VaraiTamas/yoRadio/yoRadio/locale/glcdfont/GR/readme.txt

Η βιβλιοθήκη Adafruit_GFX δεν υποστηρίζει Unicode. 
Επομένως, για να εμφανίσουμε ελληνικούς χαρακτήρες Unicode, πρέπει:
1) Να αλλάξουμε τη γραμματοσειρά Arduino/libraries/Adafruit_GFX_Library/glcdfont.c
2) Να γράψουμε μια συνάρτηση μετατροπής unicode σε ascii για τα ελληνικά.
   Ένα παράδειγμα μιας τέτοιας συνάρτησης για τη ρωσική γλώσσα υπάρχει στο αρχείο 
   yoRadio/src/displays/tools/utf8Rus.cpp, οπότε σε αυτό κάνουμε τις απαραίτητες 
   προσθήκες για την εμφάνιση των ελληνικών χαρακτήρων.

Τα αρχεία από αυτό το ZIP έχουν τις απαραίτητες αλλαγές για υποστήριξη ελληνικών 
και πρέπει να αντιγραφούν στις ακόλουθες τοποθεσίες:
ο) glcdfont.c           ----> \Arduino\libraries\Adafruit_GFX_Library
