VaraiTamas/yoRadio/Aliexpress/Aliexpress_links.txt

********************************************************************************************************************
******************************************       Hozzávalók / accessories:      ************************************
********************************************************************************************************************

- ESP32 S3 Development Board 2.4G Wifi Bluetooth Module Dual-Core Processor ESP32-S3 N16R8 44Pin Type-C ESP32-S3
https://www.aliexpress.com/item/1005009170360406.html

- Interface I2S PCM5102A DAC Decoder GY-PCM5102 I2S Player Module For Raspberry Pi pHAT Format Board Digital PCM5102 Audio Board
https://www.aliexpress.com/item/1005006104038963.html

- IPS 4.0 Inch Red Module ILI9488 Factory TFT LCD 480*320 DIY Display 14 Pin Electronic Board
https://www.aliexpress.com/item/1005006287831546.html

- 1-10Pcs With Switch Rotary Encoder Module for Arduino Brick Sensor Development Round Audio Rotating Potentiometer Knob Cap EC11
https://www.aliexpress.com/item/1005001696915804.html?spm=a2g0o.order_list.order_list_main.116.1e251802zpJnqp

- 5 Volt 1-10Pcs AC-DC 3.3V/5V/12V Precision Buck Converter AC220v toDC 3.3V/5V/12V DC step down Transformer power supply module 1A 12W
https://www.aliexpress.com/item/10000159007917.html

- 4PCS RCA Female Socket Lotus Connector Chassis Panel Mount Adapter Audio Terminal Plug 3.5mm AV Plug Gold Plated
https://www.aliexpress.com/item/1005008621695365.html

- 1~10pcs 2 Pin 4 Pin USB 2.0 Female Power Jack 2P 4P USB 2.0 Charging Port Connector Data Interface with Cable USB Charger Socket
https://www.aliexpress.com/item/1005005673022752.html

- PJ-392A 3/4 Pin 3.5mm Audio Jack Socket 3/4 Pole Stereo Solder Panel Mount 3.5 mm Headphone Female Socket Connector With Nut
https://www.aliexpress.com/item/1005003621329893.html

- Universal Learn Remote Control Work for 2 devices Copy IR Code for TV VCR STB DVD DVB BOX 2 in 1 Controller Easy for Old People.
https://www.aliexpress.com/item/32960027990.html

- VS1838B IR sensor
https://www.aliexpress.com/item/1005005407437987.html

- 48 x 15 mm-es 4Pcs Speaker Spikes Stand Feets Audio Active Speakers Repair Parts Accessories DIY For Home Theater Sound System
https://www.aliexpress.com/item/1005006345065523.html

- Grwibeou 2 IN 1 USB Bluetooth 5.0 Adapter Transmiter 3.5mm AUX Jack
https://www.aliexpress.com/item/1005006421639768.html

- 16mm Metal Illuminated Black Push Button Switch Led Light 5v Momentary Latching Waterproof Power Flat Head
https://www.aliexpress.com/item/1005009195056493.html

- 10PCS Single Row Pin Female Header Socket Pitch 2.54mm 22p Pin Connector
https://www.aliexpress.com/item/1005007563546219.html

- 25 x 13mm Black aluminum knob encoder sound card potentiometer inner hole 6mm knob volume power amplifier adjustment metal cap
https://www.aliexpress.com/item/1005008473117765.html

- 2.4GHz 3dBi WiFi 2.4g Antenna Aerial RP-SMA Male wireless router+ 17cm PCI U.FL IPX to RP SMA Male Pigtail Cable ESP8266 ESP32
https://www.aliexpress.com/item/1005006781542881.html

- CPQ For TAA 125V/15A 250V/10A 12mm Thread Screw Cap Panel Mounted Fuse Holders 5 Pieces 2025
https://www.aliexpress.com/item/1005009550935137.html

3.3V 1 Channel Relay Module High And Low Level Trigger Dual Optocoupler Isolation Relay Module Board
https://www.aliexpress.com/item/1005005514531757.html

4PCS Audio Isolation Feet 40*10mm Plastic Amplifier Feet Speaker Pad CD DAC Speakers Shock Absorption Feet Pad
https://www.aliexpress.com/item/1005007017368257.html
