VaraiTamas/yoRadio/docs/presets.md

## 📻 YoRadio – Presets kezelési útmutató
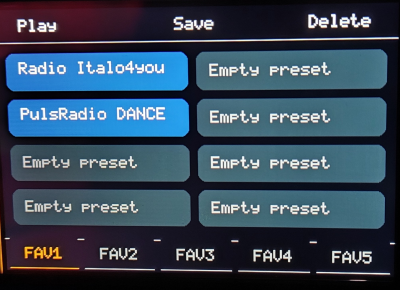
[picture p17: images/presets.png]
Projekt logó


A Presets rendszer lehetővé teszi, hogy bármely rádióállomást elments és később egyetlen érintéssel visszahívd, még akkor is, ha a playlist időközben megváltozik. Érintéses képernyőmód bekapcsolása szükséges és csak 320x480 pixeles felbontáson működik. Mentés az NVS memóriába történik.

## ▶️ Egy preset használata

- Lejátszás módban a felső címsáv rövid érintésével lépj a Presets képernyőre.

- Egy képernyőn 8 darab kártya található melyek alá egy - egy rádióállomás menthető. 5 darab képernyő tehát összesen 40 darab csatornát lehet elmenteni. 
- A fejlécen lévő Lejátszás Mentés Törlés feliratok alatt a kártya érintésével egy idővonal indul el mely mutatja, ha elengedjük a kártyát melyik funkció fog végrehajtódni. 
    - Lejátszásnál a mentett csatorna indul.
    - Mentésnél az éppen hallgatott csatorna kerül mentésre ha volt eddig mentve a kártyára, azt felülírja.
    - Törlésnél a kártyára memóriája kerül kiürítésre.
- Alul található FAV1 - FAV5 gombokkal lehet váltani a lapokat. Hosszan nyomva a FAV gombon megjelenik egy billentyűzet és ott szerkeszthető a FAV gomb felirata 12 karakterig. Ha túl hosszú a szöveg a betűméret kicsinyítésre kerül. 

A lejátszási listának nincs hatása a mentett presetekre. Ha közben a lejátszási lista cserélve van a presets kártyákra mentett csatornák nem változnak.

👻 Szellem presetek javítása

Ha korábban elfogyott az NVS memória, előfordulhat:

Van ID, de nincs név vagy URL program automatikusan:

- Törli az ilyen hibás bejegyzéseket

- Nem engedi, hogy „láthatatlan” preset maradjon

---

### Ha támogatni szeretnéd a munkámat itt meghívhatsz egy kávéra!!!     
<a href="https://buymeacoffee.com/vtom">
    
</a>
