VaraiTamas/yoRadio/images/MB_2.0/MB_search.md

# Új WEB kereső hozzáadva v2.0 (by Mirosław Bubka)<br><br>
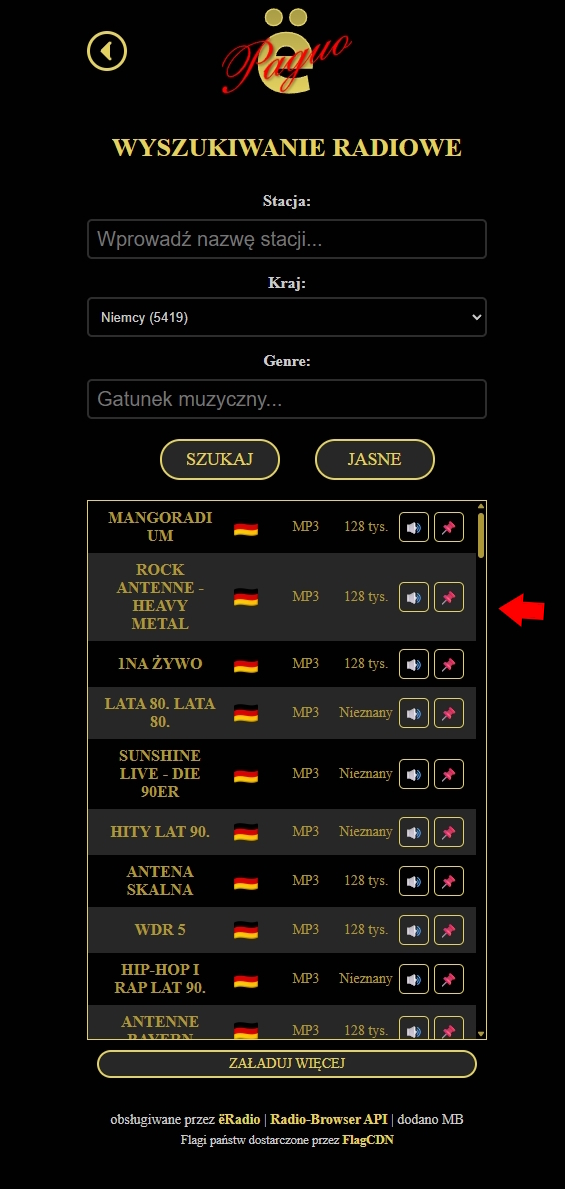
[picture p18: images/MB_2.0/1.jpg]
<br><br>
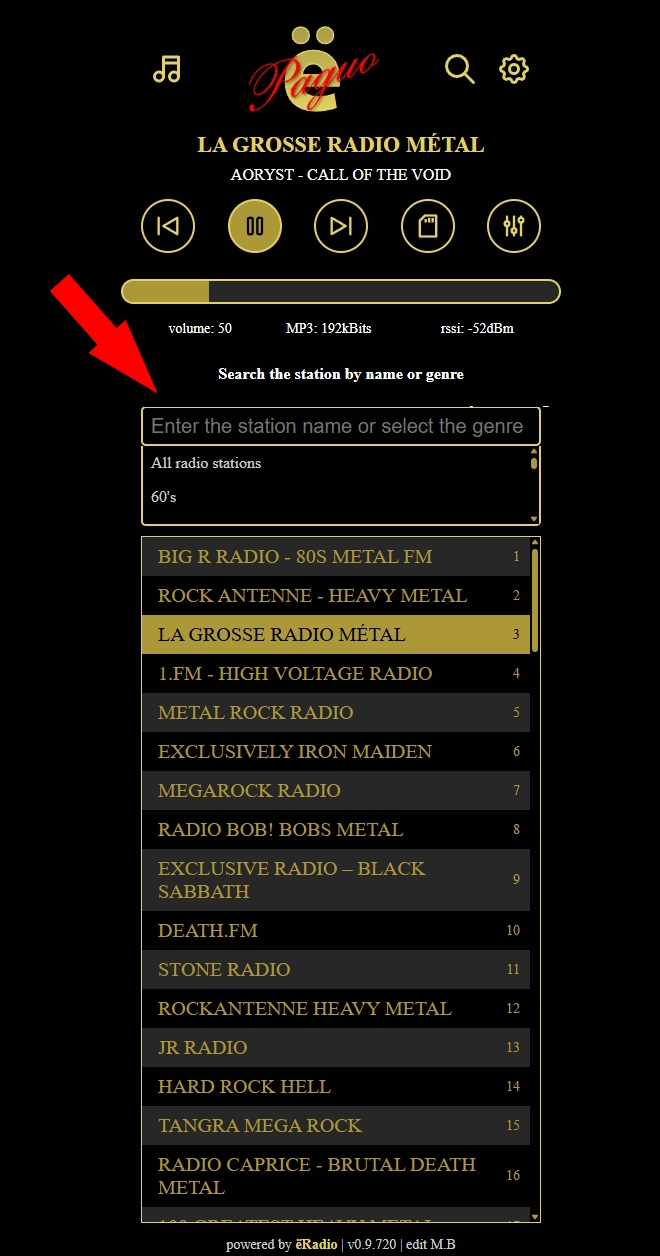
[picture p19: images/MB_2.0/2.jpg]
<br><br>
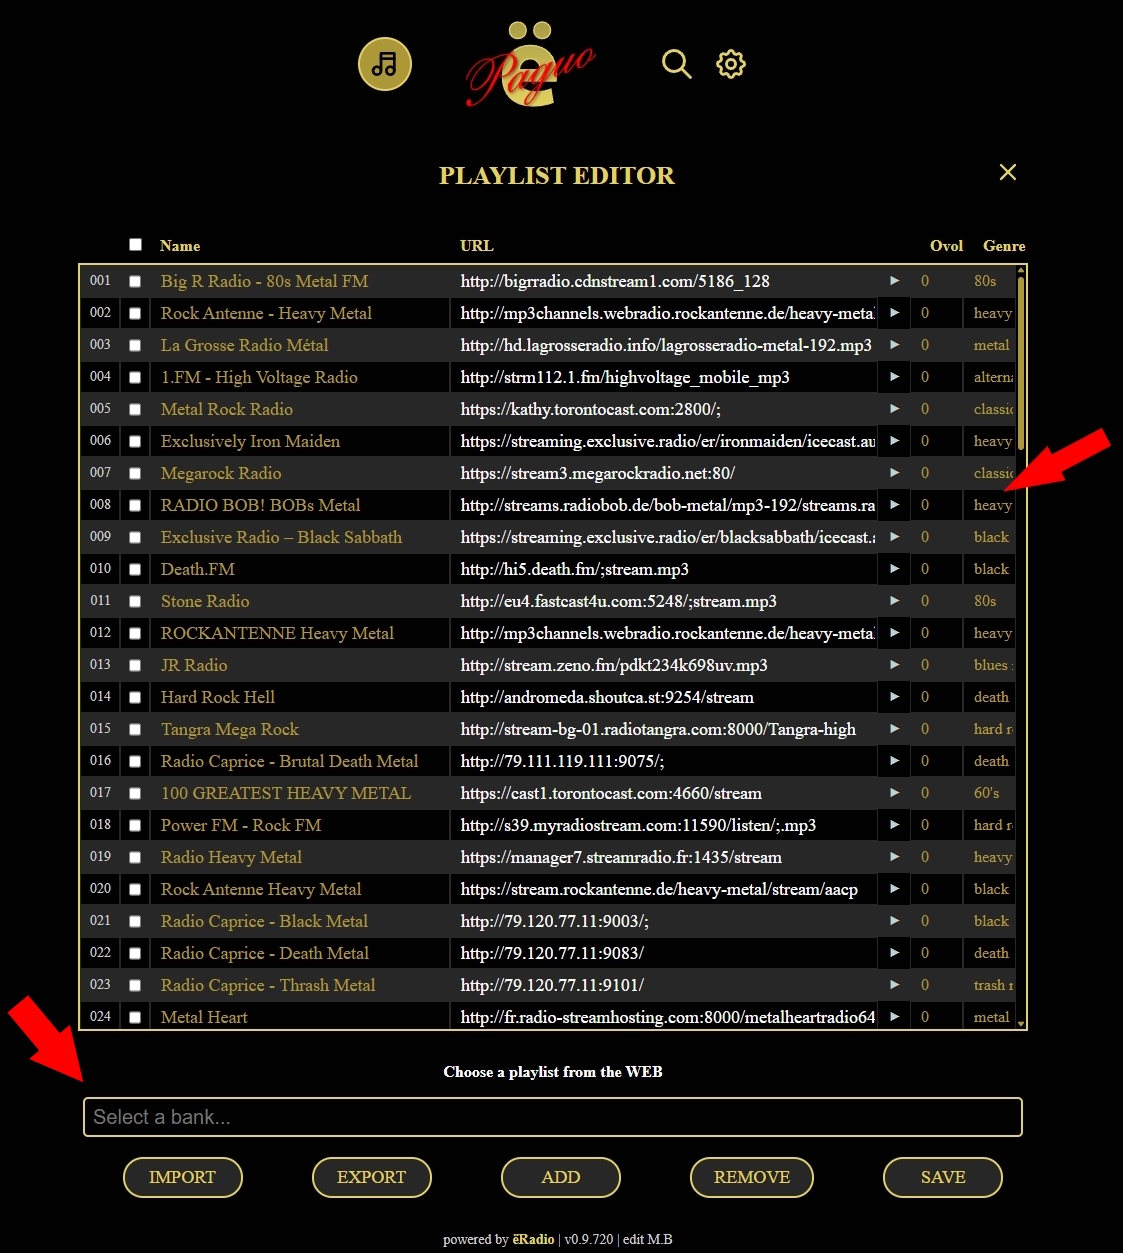
[picture p20: images/MB_2.0/3.jpg]
<br><br>
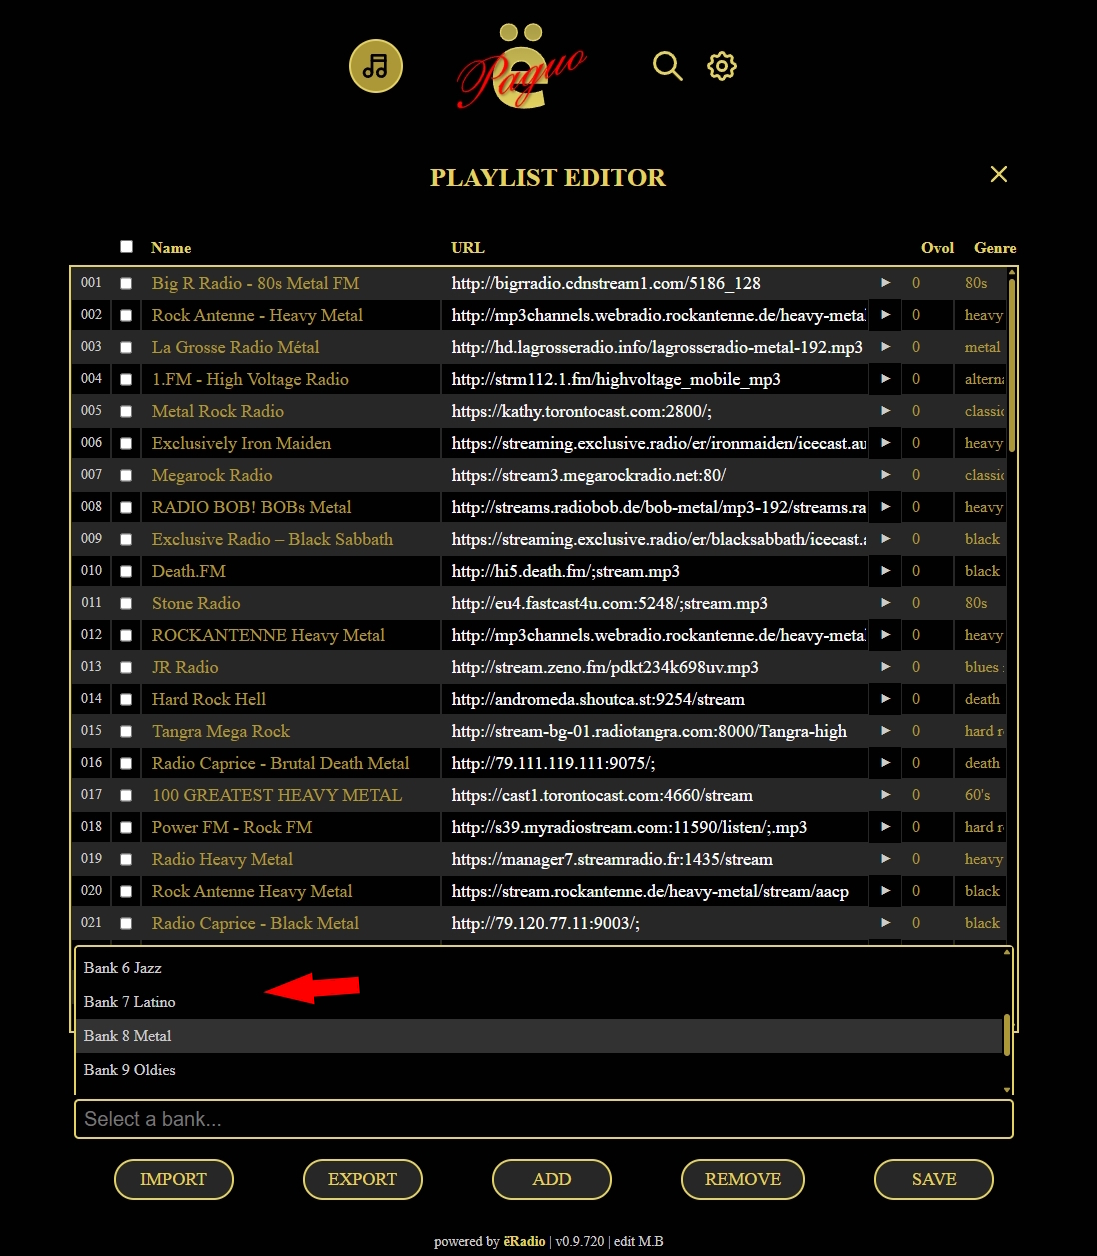
[picture p21: images/MB_2.0/4.jpg]
<br><br>
