VaraiTamas/yoRadio/images/box_back.png

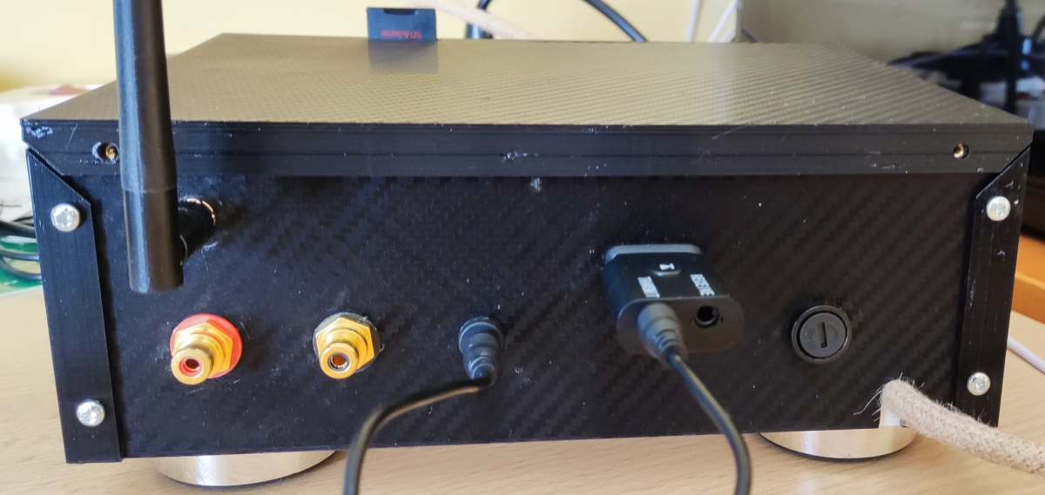
images/box_back.png
