VaraiTamas/yoRadio/images/box_front_top.png

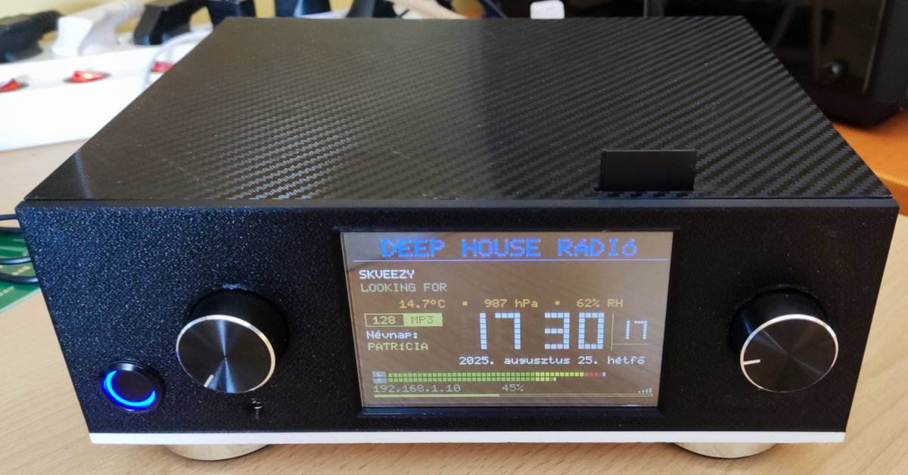
images/box_front_top.png
