VaraiTamas/yoRadio/images/box_inside_1.png

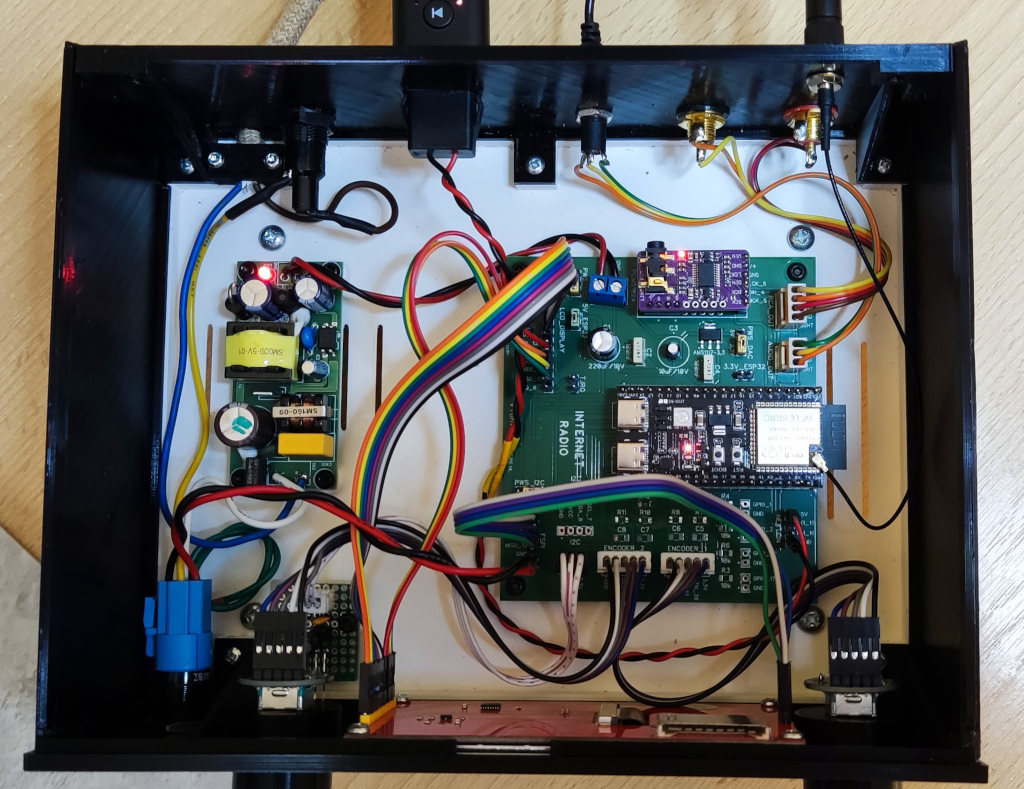
images/box_inside_1.png
