VaraiTamas/yoRadio/images/box_right.png

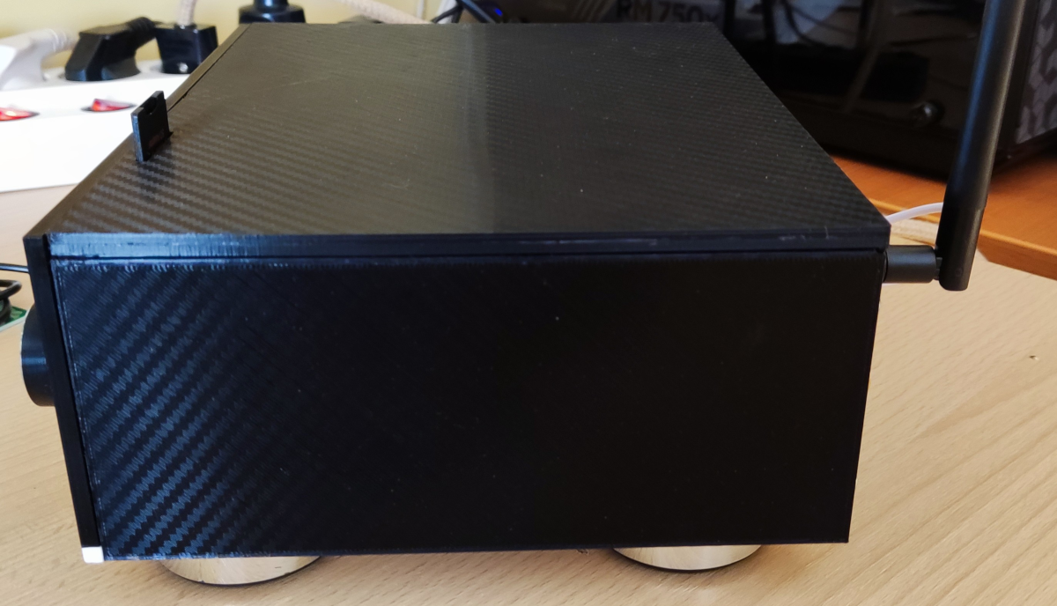
images/box_right.png
