VaraiTamas/yoRadio/PCM5102A/PCM5102A DAC I2S pinouts.jpg

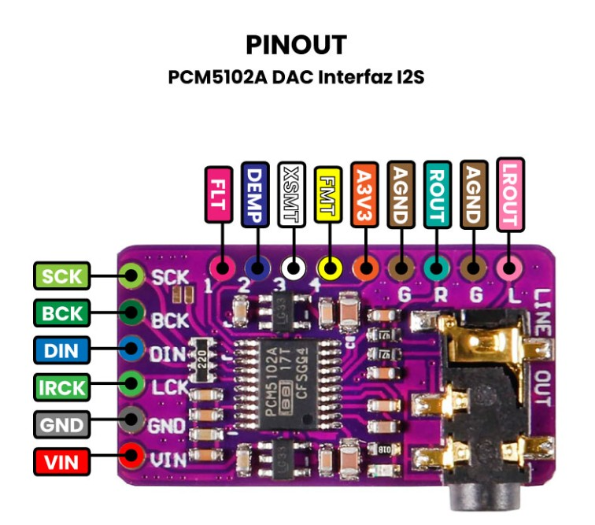
PCM5102A/PCM5102A DAC I2S pinouts.jpg
