VaraiTamas/yoRadio/Arduino IDE settings/Arduino IDE setup.png

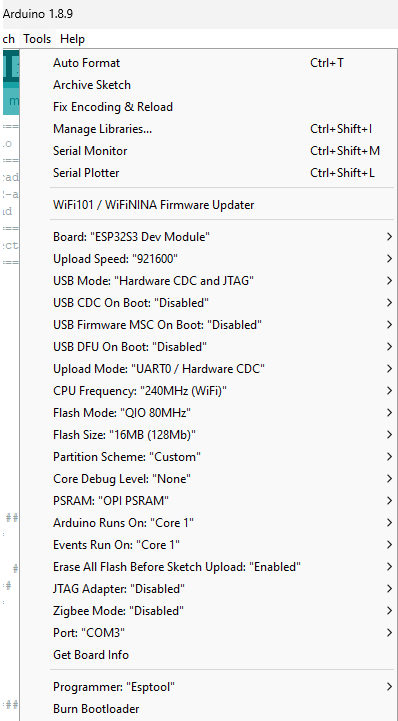
Arduino IDE settings/Arduino IDE setup.png
