VaraiTamas/yoRadio/Arduino IDE settings/Boards Manager_ESP32_v3.3.6 setup.png

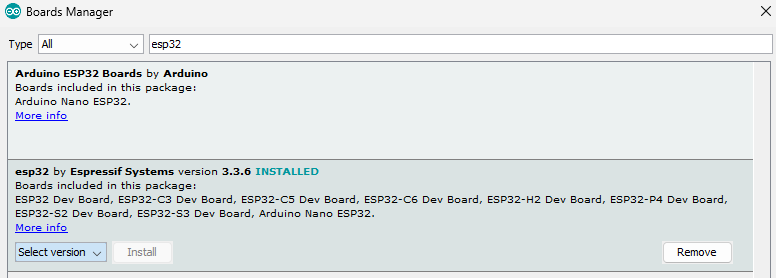
Arduino IDE settings/Boards Manager_ESP32_v3.3.6 setup.png
