VaraiTamas/yoRadio/PCB/PCB_2025_06_14/wiring diagram 2025.06.14.pdf

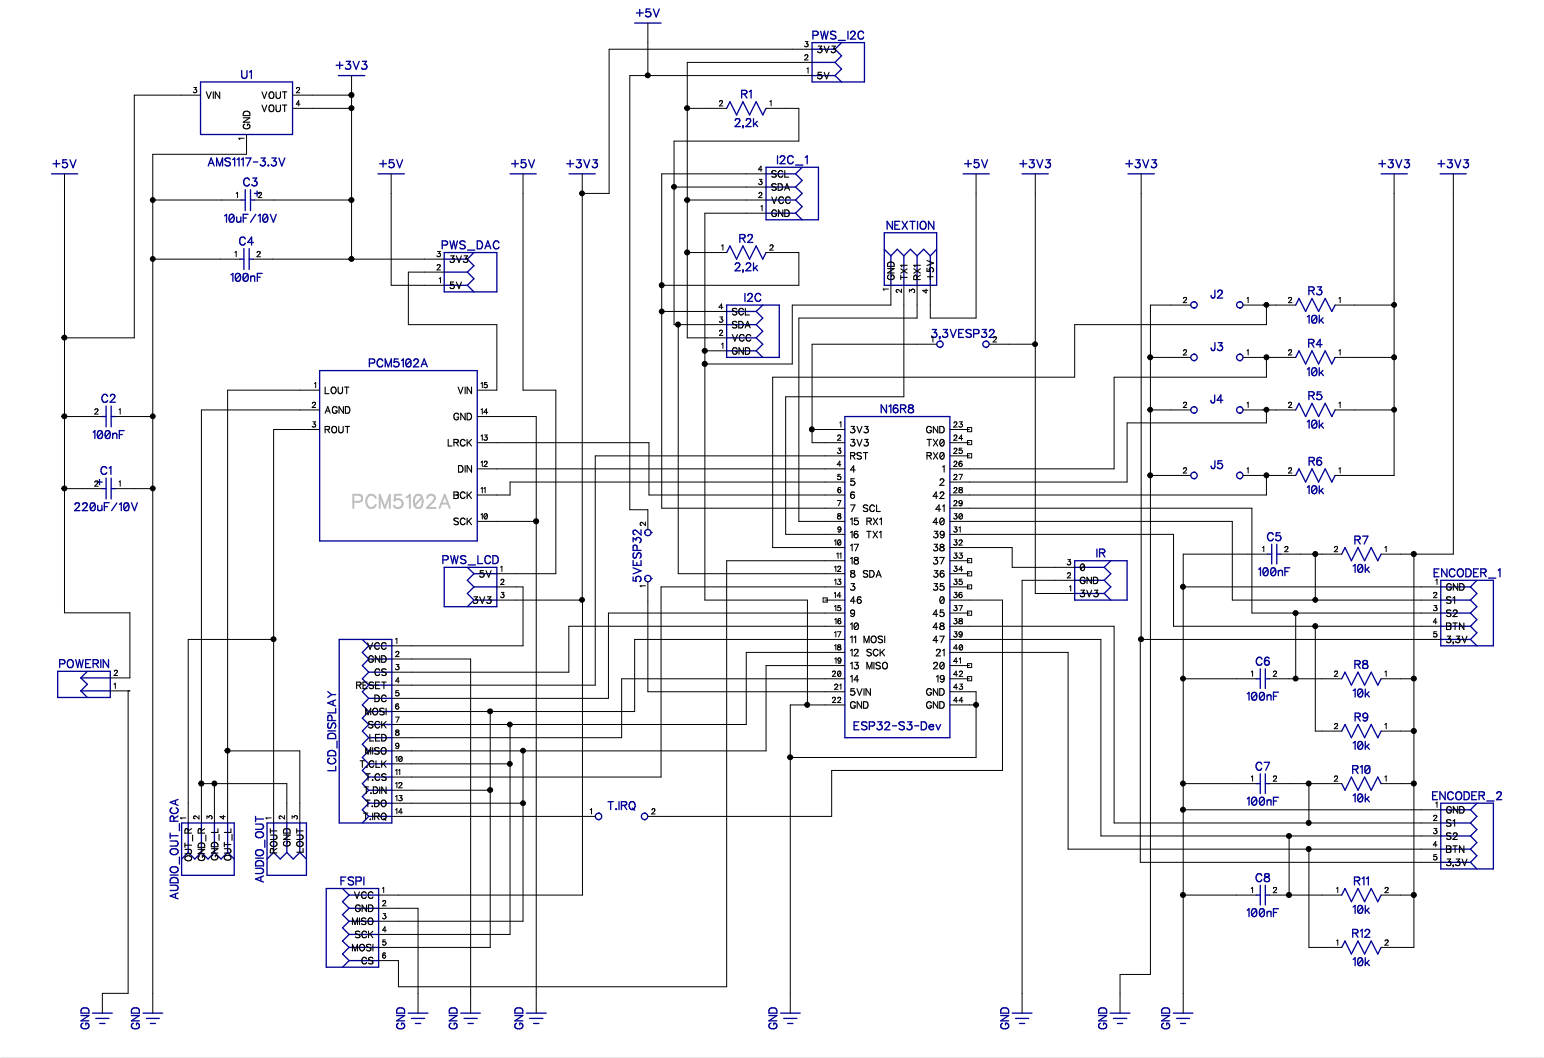
[picture p30: page 1]

3 | SCL
2 | SDA

4 | 26 27

1 | GND 3 V 3

13 MISO 19 14 20 5VIN 21

GND 22

3 | S 1
4 | S 2
5 | BTN
3,3 V
