VaraiTamas/yoRadio/PCB/PCB_2025_12_21/wiring_diagram__2025_dec_21.pdf

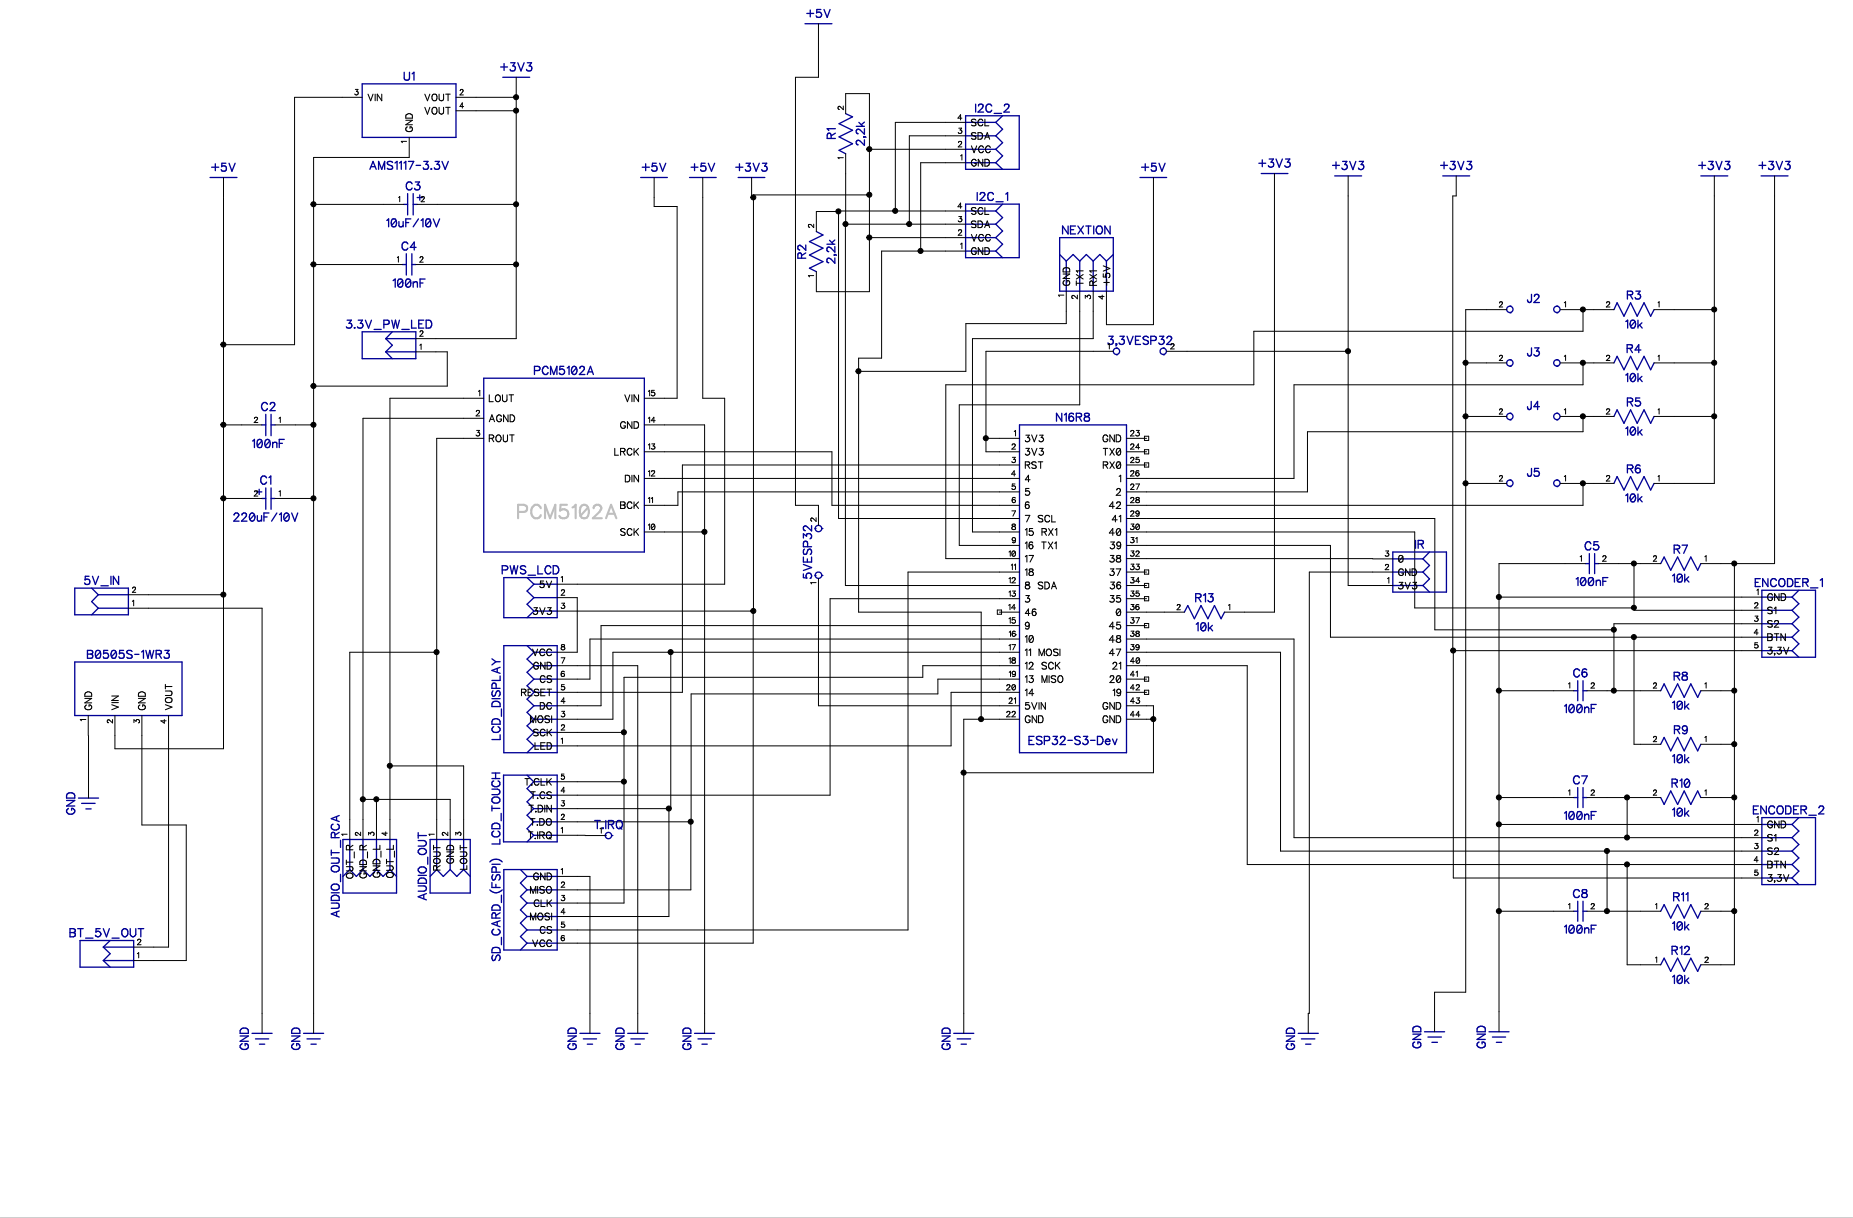
[picture p31: page 1]

10 16
11 MOSI 17
12 SCK 18
13 MISO 19 14 20 5VIN 21

GND 22
