VaraiTamas/yoRadio/PCB/Power_supply_with_IR_sensor/wiring_diagram_2026_jan_03.pdf

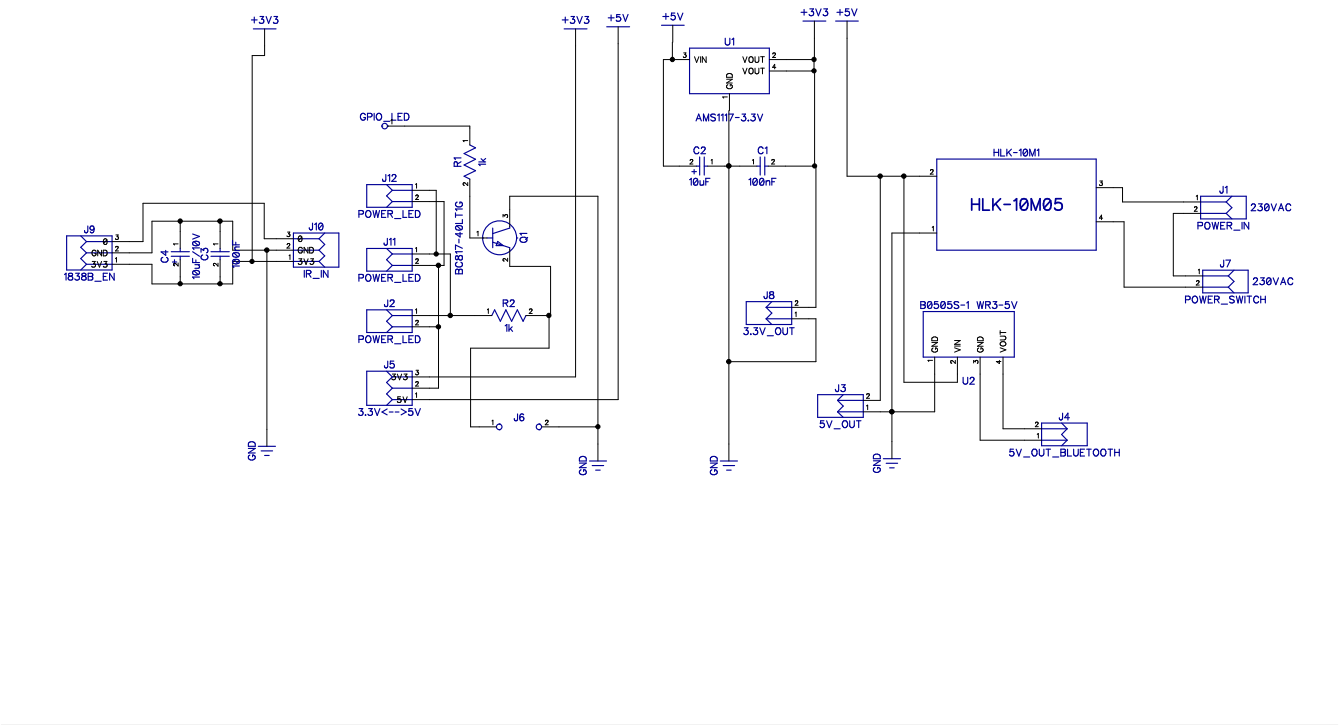
[picture p32: page 1]
