VaraiTamas/yoRadio/(list of files, drawings)

Other design files:
PCB/PCB_2025_12_21/Diptrace/PCB_2025_dec_21.dip
PCB/PCB_2025_12_21/Diptrace/schematics_2025_dec_21.dch
PCB/Power_supply_with_IR_sensor/Diptrace/power_supply_width_ir.dip
PCB/Power_supply_with_IR_sensor/Diptrace/power_supply_with_ir.dch
