VaraiTamas/yoRadio/yoRadio/src/audioI2S/Audio.cpp

/*****************************************************************************************************************************************************
    audio.cpp

    Created on: 28.10.2018                                                                                                  */
char audioI2SVers[] = "\
    Version 3.4.5h                                                                                                                            ";
/*  Updated on: Mar 18, 2026

    Author: Wolle (schreibfaul1)
    Audio library for ESP32, ESP32-S3 or ESP32-P4
    Arduino Vers. V3 is mandatory
    PSRAM is mandatory
    external DAC is mandatory

*****************************************************************************************************************************************************/

#include "Audio.h"
#include "aac_decoder/aac_decoder.h"
#include "flac_decoder/flac_decoder.h"
#include "mp3_decoder/mp3_decoder.h"
#include "opus_decoder/opus_decoder.h"
#include "psram_unique_ptr.hpp"
#include "vorbis_decoder/vorbis_decoder.h"
#include "wav_decoder/wav_decoder.h"

// constants
constexpr size_t m_frameSizeWav = 4096;
constexpr size_t m_frameSizeMP3 = 1600 * 2;
constexpr size_t m_frameSizeAAC = 1600 * 2;
constexpr size_t m_frameSizeFLAC = UINT16_MAX;   // max ogg size
constexpr size_t m_frameSizeOPUS = UINT16_MAX;   // max ogg size
constexpr size_t m_frameSizeVORBIS = UINT16_MAX; // OGG length is normally 4080 bytes, but can be reach 64KB in the metadata block
constexpr size_t m_outbuffSize = 4608 * 2;
constexpr size_t m_samplesBuff48KSize = m_outbuffSize * 8; // SRmin: 6KHz -> SRmax: 48K

constexpr size_t AUDIO_STACK_SIZE = 3500;

// static allocations for Audio task
StaticTask_t __attribute__((unused)) xAudioTaskBuffer;
StackType_t __attribute__((unused))  xAudioStack[AUDIO_STACK_SIZE];

// weak default implementation - can be overridden by user
__attribute__((weak)) void audio_process_i2s(int32_t* outBuff, int16_t validSamples, bool* continueI2S) {
    // Default: do nothing. User can provide their own implementation to process audio data.
}
__attribute__((weak)) void audio_process_raw_samples(int32_t* outBuff, int16_t validSamples) {
    // Default: do nothing. User can provide their own implementation to process audio data.
}

// —————————————————————————————————————————————————————————————————————————————————————————————————————————————————————————————————————————————————————————————————————————————————————————————————————
// 📌📌📌  A U D I O B U F F E R  📌📌📌
// —————————————————————————————————————————————————————————————————————————————————————————————————————————————————————————————————————————————————————————————————————————————————————————————————————

// AudioBuffer will be allocated in PSRAM
//
//  m_startPtr       m_readPtr                  m_writePtr                                                    m_endPtr
//   |                  |<------maxAvailableBytes----->|<--------------------- writeSpace ----------------------->|
//   ▼                  ▼                              ▼                                                          ▼
//   ---------------------------------------------------------------------------------------------------------------
//   |                         <--m_mainBuffSize-->                               |      <--m_resBuffSize -->     |
//   ---------------------------------------------------------------------------------------------------------------
//   |<---freeSpace---->|<------------filled---------->|<-------freeSpace-------->|
//                                                                                ▲
//                                                                                |
//                                                                             m_buffEnd
//   if resBuff is full copy data from resBuff to the beginning
//   if m_readPtr >= m_buff<end set m_readptr to m_startPtr + (m_readPtr - m_buffEnd)
//
//  m_startPtr                      m_writePtr                 m_readPtr                                      m_endPtr
//   |                                 |<-------writeSpace------>|<---------------maxAvailableBytes-------------->|
//   ▼                                 ▼                         ▼                ▼                               ▼
//   ---------------------------------------------------------------------------------------------------------------
//   |                        <--m_mainBuffSize-->                                |      <--m_resBuffSize -->     |
//   ---------------------------------------------------------------------------------------------------------------
//   |<------------filled------------->|<-------freeSpace------->|<----filled---->▲
//                                                                                |
//                                                                             m_buffEnd
//

AudioBuffer::AudioBuffer() {
    m_mainBuffSize = UINT16_MAX * 10;
    m_resBuffSize = UINT16_MAX;
}

AudioBuffer::~AudioBuffer() {
    ;
}

size_t AudioBuffer::getBufsize() {
    return m_mainBuffSize;
}

size_t AudioBuffer::init() {
    m_buffer.alloc(m_mainBuffSize + m_resBuffSize, "AudioBuffer");
    m_mutex = xSemaphoreCreateBinary();
    xSemaphoreGive(m_mutex);
    m_init = true;
    m_startPtr = m_buffer.get();
    m_endPtr = m_buffer.get() + m_mainBuffSize;
    m_buffEnd = m_endPtr + m_resBuffSize;
    reset();
    return m_mainBuffSize;
}

void AudioBuffer::setMaxBlocksize(uint32_t mbs) {
    m_maxBlockSize = mbs;
}

size_t AudioBuffer::getMaxBlockSize() {
    return m_maxBlockSize;
}
//----------------------------------------------------------------------------------------------------------------------------------------------------
size_t AudioBuffer::freeSpace() {
    if (!m_init) return 0;
    if (m_readPtr == m_writePtr) {
        if (m_isEmpty) { return m_mainBuffSize; }
        if (m_isFull) { return 0; }
        log_e("writePtr == readPtr, writePtr %i, readPtr %i", m_writePtr - m_startPtr, m_readPtr - m_startPtr);
    }
    if (m_readPtr < m_writePtr) {
        if (m_writePtr > m_endPtr) {
            return (m_readPtr - m_startPtr);
        } else {
            return (m_endPtr - m_writePtr) + (m_readPtr - m_startPtr);
        }
    }
    return m_readPtr - m_writePtr;
}
//----------------------------------------------------------------------------------------------------------------------------------------------------
size_t AudioBuffer::bufferFilled() {
    if (!m_init) return 0;
    xSemaphoreTake(m_mutex, portMAX_DELAY);
    size_t bufferFilled = 0;
    if (m_readPtr == m_writePtr) {
        if (m_isEmpty) {
            bufferFilled = 0;
            goto end;
        }
        if (m_isFull) {
            bufferFilled = m_mainBuffSize;
            goto end;
        }
        log_e("%s %i writePtr == readPtr, writePtr %i, readPtr %i", __FILE__, __LINE__, m_writePtr - m_startPtr, m_readPtr - m_startPtr);
    }
    if (m_readPtr < m_writePtr) {
        bufferFilled = (size_t)(m_writePtr - m_readPtr);
        goto end;
    }
    bufferFilled = (m_endPtr - m_readPtr) + (m_writePtr - m_startPtr);
end:
    xSemaphoreGive(m_mutex);
    return bufferFilled;
}
//----------------------------------------------------------------------------------------------------------------------------------------------------
size_t AudioBuffer::writeSpace() {
    if (!m_init) return 0;
    xSemaphoreTake(m_mutex, portMAX_DELAY);
    m_writeSpace = 0;

    // Check whether a complete block still fits in at the end
    size_t spaceToEnd = m_buffEnd - m_writePtr;

    if (m_isFull) {
        m_writeSpace = 0;
        goto end;
    }

    if (m_isEmpty) {
        m_writeSpace = min(m_maxRet, spaceToEnd);
        goto end;
    }

    if (spaceToEnd == 0) { // be sure that the resBuff is full
        // Only copy if the read pointer is not in the way
        if (m_readPtr > m_startPtr + m_resBuffSize) {
            memcpy(m_startPtr, m_endPtr, m_resBuffSize);
            // log_w("wrap copy %u bytes", m_resBuffSize);
            m_writePtr = m_startPtr + m_resBuffSize;
        }
    }

    if (m_writePtr < m_readPtr) {
        if (m_readPtr >= m_endPtr) {                                       // readPtr is in resBuff?
            m_writeSpace = min(m_maxRet, (size_t)(m_endPtr - m_writePtr)); // writePtr does not enter resbuff, wait for copy im readspace
        } else {
            m_writeSpace = min(m_maxRet, (size_t)(m_readPtr - m_writePtr));
        }
        goto end;
    }
    if (m_writePtr > m_readPtr) {
        m_writeSpace = min(m_maxRet, spaceToEnd);
        goto end;
    }

    log_e("%s %i writePtr == readPtr, writePtr %i, readPtr %i", __FILE__, __LINE__, m_writePtr - m_startPtr, m_readPtr - m_startPtr);

end:
    xSemaphoreGive(m_mutex);
    return m_writeSpace;
}
//----------------------------------------------------------------------------------------------------------------------------------------------------
void AudioBuffer::bytesWritten(size_t bw) {
    if (!m_init) return;
    xSemaphoreTake(m_mutex, portMAX_DELAY);
    if (!bw) goto end;

    if (bw > m_writeSpace) log_e("writeSpace < bw, writeSpace %i, bw %i", m_writeSpace, bw); // bw must not be larger than the queried m_writeSpace

    if (m_writePtr < m_readPtr && m_writePtr + bw > m_readPtr) {
        log_e("writePtr overrruns readPtr, writePtr %i, readPtr %i, bw %i", m_writePtr - m_startPtr, m_readPtr - m_startPtr, bw);
        m_writePtr = m_readPtr;
        goto end;
    }
    if (m_writePtr + bw > m_buffEnd) {
        log_e("writePtr overrruns buffEnd, writePtr %i, buffEnd %i, bw %i", m_writePtr - m_startPtr, m_buffEnd - m_startPtr, bw);
        m_writePtr = m_buffEnd;
        goto end;
    }

    m_writePtr += bw;
    if (bw) {
        if (m_writePtr == m_readPtr) m_isFull = true;
        m_isEmpty = false;
    }

end:
    xSemaphoreGive(m_mutex);
    return;
}
//----------------------------------------------------------------------------------------------------------------------------------------------------
size_t AudioBuffer::readSpace() {
    if (!m_init) return 0;
    xSemaphoreTake(m_mutex, portMAX_DELAY);

    if (m_readPtr >= m_endPtr && m_writePtr <= m_endPtr) {
        size_t len = m_readPtr - m_endPtr;
        if (m_writePtr > m_startPtr + len) {
            log_d("set new readptr to %i", len);
            m_readPtr = m_startPtr + len;
        }
    }

    m_readSpace = 0;
    if (m_isEmpty) { goto end; }

    if (m_isFull) {
        m_readSpace = min(m_maxRet, (size_t)(m_buffEnd - m_readPtr));
        goto end;
    }

    if (m_readPtr < m_writePtr) {
        m_readSpace = min(m_maxRet, (size_t)(m_writePtr - m_readPtr));
        goto end;
    }

    if (m_readPtr > m_writePtr) {
        m_readSpace = min(m_maxRet, (size_t)(m_buffEnd - m_readPtr));
        goto end;
    }

    log_e("%s %i writePtr == readPtr, writePtr %i, readPtr %i", __FILE__, __LINE__, m_writePtr - m_startPtr, m_readPtr - m_startPtr);
end:
    xSemaphoreGive(m_mutex);
    return m_readSpace;
}
//----------------------------------------------------------------------------------------------------------------------------------------------------
void AudioBuffer::bytesWasRead(size_t br) {
    if (!m_init) return;
    xSemaphoreTake(m_mutex, portMAX_DELAY);

    if (!br) goto end;

    if (m_readSpace < br) {
        log_e("readSpace < br, rspc %i, br %i", m_readSpace, br); // br must not be larger than the queried m_readSpace
        vTaskDelay(100);
        goto end;
    }

    if (m_readPtr < m_writePtr && m_readPtr + br > m_writePtr) {
        log_e("readPtr overrruns writePtr, readPtr %i, writePtr %i, br %i", m_readPtr - m_startPtr, m_writePtr - m_startPtr, br);
        m_readPtr = m_writePtr;
        vTaskDelay(100);
        goto end;
    }
    if (m_readPtr + br > m_buffEnd) {
        log_e("readPtr overrruns buffEnd, readPtr %i, buffEnd %i, bw %i", m_readPtr - m_startPtr, m_buffEnd - m_startPtr, br);
        m_readPtr = m_buffEnd;
        vTaskDelay(100);
        goto end;
    }

    m_readPtr += br;

    if (br) {
        if (m_readPtr == m_writePtr) {
            m_isEmpty = true;
            // log_d(" readPtr %i, writePtr %i, br %i", m_readPtr - m_startPtr, m_writePtr - m_startPtr, br);
        }
        m_isFull = false;
    }

end:
    xSemaphoreGive(m_mutex);
    return;
}
//----------------------------------------------------------------------------------------------------------------------------------------------------
uint8_t* AudioBuffer::getWritePtr() {
    return m_writePtr;
}

uint8_t* AudioBuffer::getReadPtr() {
    return m_readPtr;
}

void AudioBuffer::reset() {
    m_writePtr = m_buffer.get();
    m_readPtr = m_buffer.get();
    m_isEmpty = true;
    m_isFull = false;
    m_readSpace = 0;
    m_writeSpace = min(m_maxRet, (size_t)(m_buffEnd - m_writePtr));
}

void AudioBuffer::showStatus() {
    printf("\nfilled %i, free %i\n", bufferFilled(), freeSpace());
    printf("writeSpace %i, readSpace %i\n", writeSpace(), readSpace());
    printf("writePtr %i, readPtr %i\n", m_writePtr - m_startPtr, m_readPtr - m_startPtr);
    printf("isEmpty %i, isFull %i\n\n", m_isEmpty, m_isFull);
}

// —————————————————————————————————————————————————————————————————————————————————————————————————————————————————————————————————————————————————————————————————————————————————————————————————————
// 📌📌📌  A U D I O   📌📌📌
// —————————————————————————————————————————————————————————————————————————————————————————————————————————————————————————————————————————————————————————————————————————————————————————————————————
Audio::Audio(uint8_t i2sPort) {

    m_f_I2S_init = false;
    mutex_playAudioData = xSemaphoreCreateMutex();
    mutex_audioTask = xSemaphoreCreateMutex();
    mutex_audioTaskIsDecoding = xSemaphoreCreateMutex();

    clientsecure.setInsecure();
    m_i2s_items.i2s_num = i2sPort; // i2s port number

    // -------- I2S configuration -------------------------------------------------------------------------------------------
    memset(&m_i2s_chan_cfg, 0, sizeof(i2s_chan_config_t));
    m_i2s_chan_cfg.id = (i2s_port_t)m_i2s_items.i2s_num;  // I2S_NUM_AUTO, I2S_NUM_0, I2S_NUM_1
    m_i2s_chan_cfg.role = I2S_ROLE_MASTER;                // I2S controller master role, bclk and lrc signal will be set to output
    m_i2s_chan_cfg.dma_desc_num = m_i2s_items.DESC_NUM;   // number of DMA buffer
    m_i2s_chan_cfg.dma_frame_num = m_i2s_items.FRAME_NUM; // I2S frame number in one DMA buffer.
    m_i2s_chan_cfg.auto_clear = true;                     // i2s will always send zero automatically if no data to send
    m_i2s_chan_cfg.allow_pd = false;
    m_i2s_chan_cfg.intr_priority = 2;
    i2s_new_channel(&m_i2s_chan_cfg, &m_i2s_tx_handle, NULL);

    memset(&m_i2s_std_cfg, 0, sizeof(i2s_std_config_t));
    m_i2s_std_cfg.slot_cfg = I2S_STD_PHILIPS_SLOT_DEFAULT_CONFIG(I2S_DATA_BIT_WIDTH_32BIT, I2S_SLOT_MODE_STEREO); // Set to enable bit shift in Philips mode
    m_i2s_std_cfg.gpio_cfg.bclk = I2S_GPIO_UNUSED;                                                                // BCLK, Assignment in setPinout()
    m_i2s_std_cfg.gpio_cfg.din = I2S_GPIO_UNUSED;                                                                 // not used
    m_i2s_std_cfg.gpio_cfg.dout = I2S_GPIO_UNUSED;                                                                // DOUT, Assignment in setPinout()
    m_i2s_std_cfg.gpio_cfg.mclk = I2S_GPIO_UNUSED;                                                                // MCLK, Assignment in setPinout()
    m_i2s_std_cfg.gpio_cfg.ws = I2S_GPIO_UNUSED;                                                                  // LRC,  Assignment in setPinout()
    m_i2s_std_cfg.gpio_cfg.invert_flags.mclk_inv = false;
    m_i2s_std_cfg.gpio_cfg.invert_flags.bclk_inv = false;
    m_i2s_std_cfg.gpio_cfg.invert_flags.ws_inv = false;
    m_i2s_std_cfg.clk_cfg.sample_rate_hz = m_i2s_items.sampleRate;
    m_i2s_std_cfg.clk_cfg.clk_src = I2S_CLK_SRC_DEFAULT;
    m_i2s_std_cfg.clk_cfg.mclk_multiple = I2S_MCLK_MULTIPLE_256;
    i2s_channel_init_std_mode(m_i2s_tx_handle, &m_i2s_std_cfg);
}
// —————————————————————————————————————————————————————————————————————————————————————————————————————————————————————————————————————————————————————————————————————————————————————————————————————
Audio::~Audio() {
    stopSong();
    setDefaults();

    i2s_channel_disable(m_i2s_tx_handle);
    i2s_del_channel(m_i2s_tx_handle);
    stopAudioTask();
    vSemaphoreDelete(mutex_playAudioData);
    vSemaphoreDelete(mutex_audioTask);
    vSemaphoreDelete(mutex_audioTaskIsDecoding);
}
// —————————————————————————————————————————————————————————————————————————————————————————————————————————————————————————————————————————————————————————————————————————————————————————————————————
void Audio::destroy_decoder() {
    if (m_decoder && m_decoder->isValid()) {
        info(*this, evt_info, "%sDecoder has been destroyed", m_decoder->whoIsIt());
        m_decoder->reset();
        m_decoder.reset();
    }
}
// —————————————————————————————————————————————————————————————————————————————————————————————————————————————————————————————————————————————————————————————————————————————————————————————————————
std::unique_ptr<Decoder> Audio::createDecoder(const std::string& type) {
    destroy_decoder();
    if (type == "MP3") return std::make_unique<MP3Decoder>(*this);
    if (type == "FLAC") return std::make_unique<FlacDecoder>(*this);
    if (type == "OPUS") return std::make_unique<OpusDecoder>(*this);
    if (type == "AAC") return std::make_unique<AACDecoder>(*this);
    if (type == "VORBIS") return std::make_unique<VorbisDecoder>(*this);
    if (type == "WAV") return std::make_unique<WavDecoder>(*this);
    return nullptr;
}
// —————————————————————————————————————————————————————————————————————————————————————————————————————————————————————————————————————————————————————————————————————————————————————————————————————
void Audio::initInBuff() {
    if (!InBuff.isInitialized()) {
        size_t size = InBuff.init();
        if (size > 0) { info(*this, evt_info, "inputBufferSize: %u bytes", size - 1); }
    }
}
// —————————————————————————————————————————————————————————————————————————————————————————————————————————————————————————————————————————————————————————————————————————————————————————————————————
esp_err_t Audio::I2Sstart() {
    zeroI2Sbuff();
    esp_err_t err = ESP_FAIL;
    if (!m_f_i2s_channel_enabled) {
        err = i2s_channel_enable(m_i2s_tx_handle);
        if (err == ESP_OK) m_f_i2s_channel_enabled = true;
    }
    return err;
}
// —————————————————————————————————————————————————————————————————————————————————————————————————————————————————————————————————————————————————————————————————————————————————————————————————————
esp_err_t Audio::I2Sstop() {
    m_outBuff.clear();                                                  // Clear OutputBuffer
    m_samplesBuff48K.clear();                                           // Clear samplesBuff48K
    std::fill(std::begin(m_inputHistory), std::end(m_inputHistory), 0); // Clear history in samplesBuff48K
    esp_err_t err = ESP_FAIL;
    if (m_f_i2s_channel_enabled) err = i2s_channel_disable(m_i2s_tx_handle);
    m_f_i2s_channel_enabled = false;
    return err;
}
// —————————————————————————————————————————————————————————————————————————————————————————————————————————————————————————————————————————————————————————————————————————————————————————————————————
void Audio::zeroI2Sbuff() {
    uint8_t buff[2] = {0, 0}; // From IDF V5 there is no longer the zero_dma_buff() function.
    size_t  bytes_loaded = 0; // As a replacement, we write a small amount of zeros in the buffer and thus reset the entire buffer.
    i2s_channel_preload_data(m_i2s_tx_handle, buff, 2, &bytes_loaded);
}
// —————————————————————————————————————————————————————————————————————————————————————————————————————————————————————————————————————————————————————————————————————————————————————————————————————
void Audio::setDefaults() {
    stopSong();
    initInBuff(); // initialize InputBuffer if not already done
    InBuff.reset();
    m_outBuff.clear();        // Clear OutputBuffer
    m_samplesBuff48K.clear(); // Clear samplesBuff48K
    vector_clear_and_shrink(m_playlistURL);
    vector_clear_and_shrink(m_playlistContent);
    vector_clear_and_shrink(m_syltLines);
    m_syltTimeStamp.clear();
    m_hashQueue.clear();
    m_hashQueue.shrink_to_fit(); // uint32_t vector
    client.stop();
    clientsecure.stop();
    m_client = static_cast<NetworkClient*>(&client); /* default to *something* so that no NULL deref can happen */
    ts_parsePacket(0, 0, 0);                         // reset ts routine
    m_lastM3U8host.reset();

    AUDIO_LOG_DEBUG("buffers freed, free Heap: %lu bytes", (long unsigned int)ESP.getFreeHeap());

    m_f_timeout = false;
    m_f_chunked = false; // Assume not chunked
    m_f_firstmetabyte = false;
    m_f_playing = false;
    //    m_f_ssl = false;
    m_f_metadata = false;
    m_f_tts = false;
    m_f_firstCall = true;       // InitSequence for processWebstream and processLocalFile
    m_cat.firstCall = true;     // InitSequence for calculateAudioTime
    m_pplM3U8.firstCall = true; // InitSequence for parsePlaylist_M3U8
    m_f_firstPlayCall = true;   // InitSequence for playAudioData
    //    m_f_running = false;       // already done in stopSong
    m_f_firstLoop = true;
    m_f_unsync = false;   // set within ID3 tag but not used
    m_f_exthdr = false;   // ID3 extended header
    m_f_rtsp = false;     // RTSP (m3u8)stream
    m_f_m3u8data = false; // set again in processM3U8entries() if necessary
    m_f_continue = false;
    m_f_ts = false;
    m_f_ogg = false;
    m_f_m4aID3dataAreRead = false;
    m_f_stream = false;
    m_f_decode_ready = false;
    m_f_eof = false;
    m_f_ID3v1TagFound = false;
    m_f_lockInBuffer = false;
    m_f_acceptRanges = false;
    m_f_connectionClose = false;

    m_streamType = ST_NONE;
    m_codec = CODEC_NONE;
    m_playlistFormat = FORMAT_NONE;
    m_dataMode = AUDIO_NONE;
    m_streamTitle.assign("");
    m_resumeFilePos = -1;
    m_audioCurrentTime = 0; // Reset playtimer
    m_audioFileDuration = 0;
    m_audioDataStart = 0;
    m_audioDataSize = 0;
    m_audioFileSize = 0;
    m_avr_bitrate = 0;
    m_nominal_bitrate = 0;
    m_bytesNotConsumed = 0; // counts all not decodable bytes
    m_chunkcount = 0;       // for chunked streams
    m_curSample = 0;
    m_metaint = 0;        // No metaint yet
    m_LFcount = 0;        // For end of header detection
    m_controlCounter = 0; // Status within readID3data() and readWaveHeader()
    m_channels = 2;       // assume stereo #209
    m_ID3Size = 0;
    m_haveNewFilePos = 0;
    m_validSamples = 0;
    m_M4A_chConfig = 0;
    m_M4A_objectType = 0;
    m_M4A_sampleRate = 0;
    m_lastGranulePosition = 0;
    m_validSamples = 0;
    std::fill(std::begin(m_inputHistory), std::end(m_inputHistory), 0);
    if (m_f_reset_m3u8Codec) { m_m3u8Codec = CODEC_AAC; } // reset to default
    m_f_reset_m3u8Codec = true;
}

// —————————————————————————————————————————————————————————————————————————————————————————————————————————————————————————————————————————————————————————————————————————————————————————————————————
void Audio::setConnectionTimeout(uint16_t timeout_ms, uint16_t timeout_ms_ssl) {
    if (timeout_ms) m_timeout_ms = timeout_ms;
    if (timeout_ms_ssl) m_timeout_ms_ssl = timeout_ms_ssl;
}

/*
    Text to speech API provides a speech endpoint based on our TTS (text-to-speech) model.
    More info: https://platform.openai.com/docs/guides/text-to-speech/text-to-speech

    Request body:
    model (string) [Required] - One of the available TTS models: tts-1 or tts-1-hd
    input (string) [Required] - The text to generate audio for. The maximum length is 4096 characters.
    instructions (string) [Optional] - A description of the desired characteristics of the generated audio.
    voice (string) [Required] - The voice to use when generating the audio. Supported voices are alloy, echo, fable, onyx, nova, and shimmer.
    response_format (string) [Optional] - Defaults to mp3. The format to audio in. Supported formats are mp3, opus, aac, and flac.
    speed (number) [Optional] - Defaults to 1. The speed of the generated audio. Select a value from 0.25 to 4.0. 1.0 is the default.

    Usage: audio.openai_speech(OPENAI_API_KEY, "tts-1", input, instructions, "shimmer", "mp3", "1");
*/
bool Audio::openai_speech(const String& api_key, const String& model, const String& input, const String& instructions, const String& voice, const String& response_format, const String& speed) {
    ps_ptr<char> host;
    host.assign("api.openai.com");
    char path[] = "/v1/audio/speech";

    if (input == "") {
        AUDIO_LOG_WARN("input text is empty");
        stopSong();
        return false;
    }
    xSemaphoreTakeRecursive(mutex_playAudioData, 0.3 * configTICK_RATE_HZ);

    setDefaults();
    m_f_ssl = true;

    m_speechtxt.assign(input.c_str());

    // Escape special characters in input
    String input_clean = "";
    for (int i = 0; i < input.length(); i++) {
        char c = input.charAt(i);
        if (c == '\"') {
            input_clean += "\\\"";
        } else if (c == '\n') {
            input_clean += "\\n";
        } else if (c == '\r') {
            input_clean += "\\r";
        } else if (c == '\t') {
            input_clean += "\\t";
        } else if (c == '\\') {
            input_clean += "\\\\";
        } else if (c == '\b') {
            input_clean += "\\b";
        } else if (c == '\f') {
            input_clean += "\\f";
        } else {
            input_clean += c;
        }
    }

    // Escape special characters in instructions
    String instructions_clean = "";
    for (int i = 0; i < instructions.length(); i++) {
        char c = instructions.charAt(i);
        if (c == '\"') {
            instructions_clean += "\\\"";
        } else if (c == '\n') {
            instructions_clean += "\\n";
        } else if (c == '\r') {
            instructions_clean += "\\r";
        } else if (c == '\t') {
            instructions_clean += "\\t";
        } else if (c == '\\') {
            instructions_clean += "\\\\";
        } else if (c == '\b') {
            instructions_clean += "\\b";
        } else if (c == '\f') {
            instructions_clean += "\\f";
        } else {
            instructions_clean += c;
        }
    }

    String post_body = "{"
                       "\"model\": \"" +
                       model + "\"," + "\"stream\": true," + // add
                       "\"input\": \"" + input_clean + "\"," + "\"instructions\": \"" + instructions_clean + "\"," + "\"voice\": \"" + voice + "\"," + "\"response_format\": \"" + response_format +
                       "\"," + "\"speed\": " + speed + "}";

    String http_request =
        //  "POST " + String(path) + " HTTP/1.0\r\n" // UNKNOWN ERROR CODE (0050) - crashing on HTTP/1.1 need to use HTTP/1.0
        "POST " + String(path) + " HTTP/1.1\r\n" + "Host: " + host.get() + "\r\n" + "Authorization: Bearer " + api_key + "\r\n" + "Accept-Encoding: identity;q=1,*;q=0\r\n" +
        "User-Agent: nArija/1.0\r\n" + "Content-Type: application/json; charset=utf-8\r\n" + "Content-Length: " + post_body.length() +
        "\r\n"
        //  + "Connection: close\r\n" + "\r\n"
        + "\r\n" + post_body + "\r\n";

    bool res = true;
    int  port = 443;
    m_client = static_cast<NetworkClientSecure*>(&clientsecure);

    uint32_t t = millis();
    info(*this, evt_info, "Connect to: \"%s\"", host.get());
    res = m_client->connect(host.get(), port, m_timeout_ms_ssl);
    if (res) {
        uint32_t dt = millis() - t;
        m_lastHost.assign(host.get());
        m_currentHost.clone_from(host);
        info(*this, evt_info, "%s has been established in %lu ms", m_f_ssl ? "SSL" : "Connection", (long unsigned int)dt);
        m_f_running = true;
    }

    m_expectedCodec = CODEC_NONE;
    m_expectedPlsFmt = FORMAT_NONE;

    if (res) {
        m_client->print(http_request);
        if (response_format == "mp3") m_expectedCodec = CODEC_MP3;
        if (response_format == "opus") m_expectedCodec = CODEC_OPUS;
        if (response_format == "aac") m_expectedCodec = CODEC_AAC;
        if (response_format == "flac") m_expectedCodec = CODEC_FLAC;

        m_dataMode = HTTP_RESPONSE_HEADER;
        m_f_tts = true;
    } else {
        AUDIO_LOG_WARN("Request %s failed!", host.get());
    }
    xSemaphoreGiveRecursive(mutex_playAudioData);
    return res;
}
// —————————————————————————————————————————————————————————————————————————————————————————————————————————————————————————————————————————————————————————————————————————————————————————————————————
audiolib::hwoe_t Audio::dismantle_host(const char* host) {
    if (!host) return {};

    audiolib::hwoe_t result;

    const char* p = host;

    // 🔐 1. SSL check
    if (strncmp(p, "https://", 8) == 0) {
        result.ssl = true;
        p += 8;
    } else if (strncmp(p, "http://", 7) == 0) {
        result.ssl = false;
        p += 7;
    } else { // No valid scheme -> error or acceptance http
        result.ssl = false;
    }

    // ❓ 2. extract host (from p to ':' or '/' or '?')
    const char* host_start = p;
    const char* port_sep = strchr(p, ':');
    const char* path_sep = strchr(p, '/');
    const char* query_sep = strchr(p, '?');

    const char* host_end = p + strlen(p); // default: end of string
    if (port_sep && port_sep < host_end) host_end = port_sep;
    if (path_sep && path_sep < host_end) host_end = path_sep;
    if (query_sep && query_sep < host_end) host_end = query_sep;
    result.hwoe.copy_from(host_start, host_end - host_start);
    result.rqh_host.clone_from(result.hwoe);

    // ❓ 3. extract port
    result.port = result.ssl ? 443 : 80; // default
    if (port_sep && (!path_sep || port_sep < path_sep)) {
        result.port = atoi(port_sep + 1);
        result.rqh_host.appendf(":%u", result.port);
    }

    // ❓ 4. extract extension (path)
    if (path_sep) {
        const char* path_start = path_sep + 1;
        const char* path_end = query_sep ? query_sep : host + strlen(host);
        result.extension.copy_from(path_start, path_end - path_start);
    }

    // ❓ 5. extract query string
    if (query_sep) { result.query_string.assign(query_sep + 1); }

    return result;
}
// —————————————————————————————————————————————————————————————————————————————————————————————————————————————————————————————————————————————————————————————————————————————————————————————————————
bool Audio::connecttohost(const char* host, const char* user, const char* pwd) { // user and pwd for authentification only, can be empty

    if (!host) {
        AUDIO_LOG_ERROR("Hostaddress is empty");
        stopSong();
        return false;
    }
    if (strlen(host) > 2048) {
        AUDIO_LOG_ERROR("Hostaddress is too long");
        stopSong();
        return false;
    } // max length in Chrome DevTools

    bool     res = false;   // return value
    uint16_t port = 0;      // port number
    uint16_t authLen = 0;   // length of authorization
    uint32_t timestamp = 0; // timeout surveillance

    ps_ptr<char> c_host;       // copy of host
    ps_ptr<char> hwoe;         // host without extension
    ps_ptr<char> rqh_host;     // host for request header
    ps_ptr<char> extension;    // extension
    ps_ptr<char> query_string; // parameter
    ps_ptr<char> path;         // extension + '?' + parameter
    ps_ptr<char> rqh;          // request header

    xSemaphoreTakeRecursive(mutex_playAudioData, 0.3 * configTICK_RATE_HZ);

    c_host.copy_from(host);
    c_host.trim();
    auto dismantledHost = dismantle_host(c_host.get());

    //  https://edge.live.mp3.mdn.newmedia.nacamar.net:8000/ps-charivariwb/livestream.mp3;?user=ps-charivariwb;&pwd=ps-charivariwb-------
    //      |   |                                     |    |                              |
    //      |   |                                     |    |                              |             (query string)
    //  ssl?|   |<-----host without extension-------->|port|<----- --extension----------->|<-first parameter->|<-second parameter->.......
    //                                                     |
    //                                                     |<-----------------------------path------------------------------------>......

    m_f_ssl = dismantledHost.ssl;
    port = dismantledHost.port;
    if (dismantledHost.hwoe.valid()) hwoe.clone_from(dismantledHost.hwoe);
    if (dismantledHost.rqh_host.valid()) rqh_host.clone_from(dismantledHost.rqh_host);
    if (dismantledHost.extension.valid()) extension.clone_from(dismantledHost.extension);
    if (dismantledHost.query_string.valid()) query_string.clone_from(dismantledHost.query_string);

    if (extension.valid()) path.assign(extension.get());
    if (query_string.valid()) {
        path.append("?");
        path.append(query_string.get());
    }
    if (!hwoe.valid()) hwoe.assign("");
    if (!extension.valid()) extension.assign("");
    if (!path.valid()) path.assign("");

    path = urlencode(path.get(), true);

    // optional basic authorization
    if (user && pwd) authLen = strlen(user) + strlen(pwd);
    ps_ptr<char> authorization;
    ps_ptr<char> toEncode;
    authorization.alloc(base64_encode_expected_len(authLen + 1) + 1);
    authorization.clear();
    if (authLen > 0) {
        toEncode.assign(user);
        toEncode.append(":");
        toEncode.append(pwd);
        b64encode((const char*)toEncode.get(), toEncode.strlen(), authorization.get());
    }

    setDefaults();

    rqh.assign("GET /");
    rqh.append(path.get());
    rqh.append(" HTTP/1.1\r\n");
    rqh.appendf("Host: %s\r\n", rqh_host.get());
    rqh.append("Icy-MetaData:1\r\n");
    rqh.append("Icy-MetaData:2\r\n");
    rqh.append("Pragma: no-cache\r\n");
    rqh.append("Cache-Control: no-cache\r\n");
    rqh.append("Range: bytes=0-\r\n");
    rqh.append("Accept: */*\r\n");
    rqh.append("User-Agent: VLC/3.0.21 LibVLC/3.0.21 AppleWebKit/537.36 (KHTML, like Gecko)\r\n");
    if (authLen > 0) {
        rqh.append("Authorization: Basic ");
        rqh.append(authorization.get());
        rqh.append("\r\n");
    }
    rqh.append("Accept-Encoding: identity;q=1,*;q=0\r\n");
    rqh.append("Connection: keep-alive\r\n\r\n");

    if (m_f_ssl) {
        m_client = static_cast<NetworkClientSecure*>(&clientsecure);
        if (port == 80) port = 443;
    } else {
        m_client = static_cast<NetworkClient*>(&client);
    }

    timestamp = millis();
    m_client->setTimeout(m_f_ssl ? m_timeout_ms_ssl : m_timeout_ms);

    info(*this, evt_info, "connect to: \"%s\" on port %d path \"/%s\"", hwoe.get(), port, path.get());
    res = m_client->connect(hwoe.get(), port);

    m_expectedCodec = CODEC_NONE;
    m_expectedPlsFmt = FORMAT_NONE;

    if (res) {
        uint32_t dt = millis() - timestamp;
        info(*this, evt_info, "%s has been established in %lu ms", m_f_ssl ? "SSL" : "Connection", (long unsigned int)dt);
        m_f_running = true;
        m_client->print(rqh.get());
        if (extension.ends_with_icase(".mp3")) m_expectedCodec = CODEC_MP3;
        if (extension.ends_with_icase(".aac")) m_expectedCodec = CODEC_AAC;
        if (extension.ends_with_icase(".wav")) m_expectedCodec = CODEC_WAV;
        if (extension.ends_with_icase(".m4a")) m_expectedCodec = CODEC_M4A;
        if (extension.ends_with_icase(".ogg")) m_expectedCodec = CODEC_OGG;
        if (extension.ends_with_icase(".flac")) m_expectedCodec = CODEC_FLAC;
        if (extension.ends_with_icase("-flac")) m_expectedCodec = CODEC_FLAC;
        if (extension.ends_with_icase(".opus")) m_expectedCodec = CODEC_OPUS;
        if (extension.ends_with_icase("/opus")) m_expectedCodec = CODEC_OPUS;
        if (extension.ends_with_icase(".asx")) m_expectedPlsFmt = FORMAT_ASX;
        if (extension.ends_with_icase(".m3u")) m_expectedPlsFmt = FORMAT_M3U;
        if (extension.ends_with_icase(".pls")) m_expectedPlsFmt = FORMAT_PLS;
        if (extension.contains(".m3u8")) m_expectedPlsFmt = FORMAT_M3U8;

        m_currentHost.clone_from(c_host);
        m_lastHost.clone_from(c_host);
        info(*this, evt_lasthost, "%s", m_lastHost.c_get());
        m_dataMode = HTTP_RESPONSE_HEADER; // Handle header
        m_streamType = ST_WEBSTREAM;
    } else {
        AUDIO_LOG_ERROR("Request %s failed!", c_host.get());
        m_f_running = false;
        info(*this, evt_name, "");
        info(*this, evt_streamtitle, "");
        info(*this, evt_icydescription, "");
        info(*this, evt_icyurl, "");
    }
    xSemaphoreGiveRecursive(mutex_playAudioData);
    return res;
}
// —————————————————————————————————————————————————————————————————————————————————————————————————————————————————————————————————————————————————————————————————————————————————————————————————————
bool Audio::httpPrint(const char* host) {
    // user and pwd for authentification only, can be empty
    if (!m_f_running) return false;
    if (host == NULL) {
        AUDIO_LOG_ERROR("Hostaddress is empty");
        stopSong();
        return false;
    }

    uint16_t     port = 0;     // port number
    ps_ptr<char> c_host;       // copy of host
    ps_ptr<char> hwoe;         // host without extension
    ps_ptr<char> rqh_host;     // host in request header
    ps_ptr<char> extension;    // extension
    ps_ptr<char> query_string; // parameter
    ps_ptr<char> path;         // extension + '?' + parameter
    ps_ptr<char> rqh;          // request header
    ps_ptr<char> cur_hwoe;     // m_currenthost without extension

    c_host.copy_from(host);
    c_host.trim();
    auto dismantledHost = dismantle_host(c_host.get());

    //  https://edge.live.mp3.mdn.newmedia.nacamar.net:8000/ps-charivariwb/livestream.mp3;?user=ps-charivariwb;&pwd=ps-charivariwb-------
    //      |   |                                     |    |                              |
    //      |   |                                     |    |                              |             (query string)
    //  ssl?|   |<-----host without extension-------->|port|<----- --extension----------->|<-first parameter->|<-second parameter->.......
    //                                                     |
    //                                                     |<-----------------------------path------------------------------------------->

    m_f_ssl = dismantledHost.ssl;
    port = dismantledHost.port;
    if (dismantledHost.hwoe.valid()) hwoe.clone_from(dismantledHost.hwoe);
    if (dismantledHost.rqh_host.valid()) rqh_host.clone_from(dismantledHost.rqh_host);
    if (dismantledHost.extension.valid()) extension.clone_from(dismantledHost.extension);
    if (dismantledHost.query_string.valid()) query_string.clone_from(dismantledHost.query_string);

    if (extension.valid()) path.assign(extension.get());
    if (query_string.valid()) {
        path.append("?");
        path.append(query_string.get());
    }
    if (!hwoe.valid()) hwoe.assign("");
    if (!extension.valid()) extension.assign("");
    if (!path.valid()) path.assign("");

    path = urlencode(path.get(), true);

    if (!m_currentHost.valid()) m_currentHost.assign("");
    auto dismantledLastHost = dismantle_host(m_currentHost.get());
    cur_hwoe.clone_from(dismantledLastHost.hwoe);

    bool f_equal = true;
    if (hwoe.equals(cur_hwoe) && port == dismantledLastHost.port) {
        f_equal = true;
    } else {
        f_equal = false;
    }

    rqh.assign("GET /");
    rqh.append(path.get());
    rqh.append(" HTTP/1.1\r\n");
    rqh.appendf("Host: %s\r\n", rqh_host.get());
    rqh.append("Icy-MetaData:1\r\n");
    rqh.append("Icy-MetaData:2\r\n");
    rqh.append("Accept:*/*\r\n");
    rqh.append("User-Agent: VLC/3.0.21 LibVLC/3.0.21 AppleWebKit/537.36 (KHTML, like Gecko)\r\n");
    rqh.append("Accept-Encoding: identity;q=1,*;q=0\r\n");
    rqh.append("Connection: keep-alive\r\n\r\n");

    info(*this, evt_info, "next URL: \"%s\"", c_host.get());

    if (f_equal == false) {
        if (m_client->connected()) m_client->stop();
    }
    if (!m_client->connected()) {
        if (m_f_ssl) {
            m_client = static_cast<NetworkClientSecure*>(&clientsecure);
            if (m_f_ssl && port == 80) port = 443;
        } else {
            m_client = static_cast<NetworkClient*>(&client);
        }
        if (f_equal) info(*this, evt_info, "The host has disconnected, reconnecting");

        if (!m_client->connect(hwoe.get(), port)) {
            AUDIO_LOG_ERROR("connection lost %s", c_host.c_get());
            stopSong();
            return false;
        }
    }
    m_currentHost.clone_from(c_host);
    m_client->print(rqh.get());

    if (extension.ends_with_icase(".mp3"))
        m_expectedCodec = CODEC_MP3;
    else if (extension.ends_with_icase(".aac"))
        m_expectedCodec = CODEC_AAC;
    else if (extension.ends_with_icase(".wav"))
        m_expectedCodec = CODEC_WAV;
    else if (extension.ends_with_icase(".m4a"))
        m_expectedCodec = CODEC_M4A;
    else if (extension.ends_with_icase(".flac"))
        m_expectedCodec = CODEC_FLAC;
    else
        m_expectedCodec = CODEC_NONE;

    if (extension.ends_with_icase(".asx"))
        m_expectedPlsFmt = FORMAT_ASX;
    else if (extension.ends_with_icase(".m3u"))
        m_expectedPlsFmt = FORMAT_M3U;
    else if (extension.contains(".m3u8"))
        m_expectedPlsFmt = FORMAT_M3U8;
    else if (extension.ends_with_icase(".pls"))
        m_expectedPlsFmt = FORMAT_PLS;
    else
        m_expectedPlsFmt = FORMAT_NONE;

    m_audioFileSize = 0;
    m_dataMode = HTTP_RESPONSE_HEADER; // Handle header
    m_streamType = ST_WEBSTREAM;
    m_f_chunked = false;
    AUDIO_LOG_DEBUG("playlistFormat %s, dataMode %s, streamType: %s", plsFmtStr[m_playlistFormat], dataModeStr[m_dataMode], streamTypeStr[m_streamType]);
    return true;
}
// —————————————————————————————————————————————————————————————————————————————————————————————————————————————————————————————————————————————————————————————————————————————————————————————————————
bool Audio::httpRange(uint32_t seek, uint32_t length) {

    if (!m_f_running) return false;

    uint16_t     port = 0;     // port number
    ps_ptr<char> c_host;       // copy of host
    ps_ptr<char> hwoe;         // host without extension
    ps_ptr<char> rqh_host;     // host in request header
    ps_ptr<char> extension;    // extension
    ps_ptr<char> query_string; // parameter
    ps_ptr<char> path;         // extension + '?' + parameter
    ps_ptr<char> rqh;          // request header
    ps_ptr<char> cur_hwoe;     // m_currenthost without extension
    ps_ptr<char> range;        // e.g. "Range: bytes=124-"

    c_host.clone_from(m_currentHost);
    c_host.trim();
    auto dismantledHost = dismantle_host(c_host.get());

    //  https://edge.live.mp3.mdn.newmedia.nacamar.net:8000/ps-charivariwb/livestream.mp3;?user=ps-charivariwb;&pwd=ps-charivariwb-------
    //      |   |                                     |    |                              |
    //      |   |                                     |    |                              |             (query string)
    //  ssl?|   |<-----host without extension-------->|port|<----- --extension----------->|<-first parameter->|<-second parameter->.......
    //                                                     |
    //                                                     |<-----------------------------path------------------------------------------->

    m_f_ssl = dismantledHost.ssl;
    port = dismantledHost.port;
    if (dismantledHost.hwoe.valid()) hwoe.clone_from(dismantledHost.hwoe);
    if (dismantledHost.rqh_host.valid()) rqh_host.clone_from(dismantledHost.rqh_host);
    if (dismantledHost.extension.valid()) extension.clone_from(dismantledHost.extension);
    if (dismantledHost.query_string.valid()) query_string.clone_from(dismantledHost.query_string);

    if (extension.valid()) path.assign(extension.get());
    if (query_string.valid()) {
        path.append("?");
        path.append(query_string.get());
    }
    if (!hwoe.valid()) hwoe.assign("");
    if (!extension.valid()) extension.assign("");
    if (!path.valid()) path.assign("");

    path = urlencode(path.get(), true);

    if (!m_currentHost.valid()) m_currentHost.assign("");
    auto dismantledLastHost = dismantle_host(m_currentHost.get());
    cur_hwoe.clone_from(dismantledLastHost.hwoe);

    if (length == UINT32_MAX)
        range.assignf("Range: bytes=%li-\r\n", seek);
    else
        range.assignf("Range: bytes=%li-%li\r\n", seek, seek + length);

    rqh.assignf("GET /%s HTTP/1.1\r\n", path.get());
    rqh.appendf("Host: %s\r\n", rqh_host.get());
    rqh.append("Accept: */*\r\n");
    rqh.append("Accept-Encoding: identity;q=1,*;q=0\r\n");
    rqh.append("Cache-Control: no-cache\r\n");
    rqh.append("Connection: keep-alive\r\n");
    rqh.appendf(range.c_get());
    rqh.appendf("Referer: %s\r\n", m_currentHost.c_get());
    rqh.append("Sec-GPC: 1\r\n");
    rqh.append("User-Agent: VLC/3.0.21 LibVLC/3.0.21 AppleWebKit/537.36 (KHTML, like Gecko)\r\n\r\n");

    if (m_client->connected()) { m_client->stop(); }
    if (m_f_ssl) {
        m_client = static_cast<NetworkClientSecure*>(&clientsecure);
        if (m_f_ssl && port == 80) port = 443;
    } else {
        m_client = static_cast<NetworkClient*>(&client);
    }

    if (!m_client->connect(hwoe.get(), port)) {
        AUDIO_LOG_ERROR("connection lost %s", c_host.c_get());
        stopSong();
        return false;
    }

    // AUDIO_LOG_INFO("rqh \n%s", rqh.get());

    m_client->print(rqh.c_get());
    m_resumeFilePos = seek; // used in processWebFile()
    m_dataMode = HTTP_RANGE_HEADER;
    return true;
}
// —————————————————————————————————————————————————————————————————————————————————————————————————————————————————————————————————————————————————————————————————————————————————————————————————————
bool Audio::connecttoFS(fs::FS& fs, const char* path, int32_t fileStartTime) {

    xSemaphoreTakeRecursive(mutex_playAudioData, 0.3 * configTICK_RATE_HZ);
    ps_ptr<char> c_path;
    ps_ptr<char> audioPath;
    bool         res = false;
    m_fileStartTime = fileStartTime;
    m_codec = CODEC_NONE;

    if (!path) {
        AUDIO_LOG_ERROR("file path is not set");
        goto exit;
    } // guard
    c_path.copy_from(path); // copy from path
    c_path.trim();
    if (!c_path.contains(".")) {
        AUDIO_LOG_ERROR("No file extension found");
        goto exit;
    } // guard
    setDefaults(); // free buffers an set defaults

    if (c_path.ends_with_icase(".mp3")) m_codec = CODEC_MP3;
    if (c_path.ends_with_icase(".m4a")) m_codec = CODEC_M4A;
    if (c_path.ends_with_icase(".aac")) m_codec = CODEC_AAC;
    if (c_path.ends_with_icase(".wav")) m_codec = CODEC_WAV;
    if (c_path.ends_with_icase(".flac")) m_codec = CODEC_FLAC;
    if (c_path.ends_with_icase(".opus")) m_codec = CODEC_OGG;
    if (c_path.ends_with_icase(".ogg")) m_codec = CODEC_OGG;
    if (c_path.ends_with_icase(".oga")) m_codec = CODEC_OGG;

    if (m_codec == CODEC_OGG) m_f_ogg = true;
    if (m_codec == CODEC_NONE) { // guard
        int dotPos = c_path.last_index_of('.');
        AUDIO_LOG_WARN("The %s format is not supported", path + dotPos);
        goto exit;
    }

    if (!c_path.starts_with("/")) c_path.insert("/", 0);

    if (!fs.exists(c_path.get())) {
        AUDIO_LOG_WARN("file not found: %s", c_path.get());
        goto exit;
    }
    info(*this, evt_info, "Reading file: \"%s\"", c_path.get());
    m_audiofile = fs.open(c_path.get());
    m_dataMode = AUDIO_LOCALFILE;
    m_audioFileSize = m_audiofile.size();
    m_f_running = true;
    res = true;

exit:
    xSemaphoreGiveRecursive(mutex_playAudioData);
    return res;
}
// —————————————————————————————————————————————————————————————————————————————————————————————————————————————————————————————————————————————————————————————————————————————————————————————————————
bool Audio::connecttospeech(const char* speech, const char* lang) {
    xSemaphoreTakeRecursive(mutex_playAudioData, 0.3 * configTICK_RATE_HZ);

    setDefaults();
    char host[] = "translate.google.com.vn";
    char path[] = "/translate_tts";

    m_speechtxt.assign(speech);             // unique pointer takes care of the memory management
    auto urlStr = urlencode(speech, false); // percent encoding

    ps_ptr<char> req; // request header
    req.assign("GET ");
    req.append(path);
    req.append("?ie=UTF-8&tl=");
    req.append(lang);
    req.append("&client=tw-ob&q=");
    req.append(urlStr.get());
    req.append(" HTTP/1.1\r\n");
    req.append("Host: ");
    req.append(host);
    req.append("\r\n");
    req.append("User-Agent: Mozilla/5.0 \r\n");
    req.append("Accept-Encoding: identity\r\n");
    req.append("Accept: text/html\r\n");
    req.append("Connection: close\r\n\r\n");

    m_client = static_cast<NetworkClient*>(&client);
    info(*this, evt_info, "connect to \"%s\"", host);
    if (!m_client->connect(host, 80)) {
        AUDIO_LOG_ERROR("Connection failed");
        xSemaphoreGiveRecursive(mutex_playAudioData);
        return false;
    }
    m_client->print(req.get());

    m_f_running = true;
    m_f_ssl = false;
    m_f_tts = true;
    m_dataMode = HTTP_RESPONSE_HEADER;
    m_lastHost.assign(host);
    m_currentHost.copy_from(host);
    xSemaphoreGiveRecursive(mutex_playAudioData);
    return true;
}
// —————————————————————————————————————————————————————————————————————————————————————————————————————————————————————————————————————————————————————————————————————————————————————————————————————
void Audio::showID3Tag(const char* tag, const char* value) {
    ps_ptr<char> id3tag;
    // V2.2
    if (!strcmp(tag, "CNT")) id3tag.appendf("Play counter: %s", value, "id3tag");
    if (!strcmp(tag, "COM")) id3tag.appendf("Comments: %s", value, "id3tag");
    if (!strcmp(tag, "CRA")) id3tag.appendf("Audio encryption: %s", value, "id3tag");
    if (!strcmp(tag, "CRM")) id3tag.appendf("Encrypted meta frame: %s", value, "id3tag");
    if (!strcmp(tag, "ETC")) id3tag.appendf("Event timing codes: %s", value, "id3tag");
    if (!strcmp(tag, "EQU")) id3tag.appendf("Equalization: %s", value, "id3tag");
    if (!strcmp(tag, "IPL")) id3tag.appendf("Involved people list: %s", value, "id3tag");
    if (!strcmp(tag, "PIC")) id3tag.appendf("Attached picture: %s", value, "id3tag");
    if (!strcmp(tag, "SLT")) id3tag.appendf("Synchronized lyric/text: %s", value, "id3tag");
    if (!strcmp(tag, "TAL")) id3tag.appendf("Album/Movie/Show title: %s", value, "id3tag");
    if (!strcmp(tag, "TBP")) id3tag.appendf("BPM (Beats Per Minute): %s", value, "id3tag");
    if (!strcmp(tag, "TCM")) id3tag.appendf("Composer: %s", value, "id3tag");
    if (!strcmp(tag, "TCO")) id3tag.appendf("Content type: %s", value, "id3tag");
    if (!strcmp(tag, "TCR")) id3tag.appendf("Copyright message: %s", value, "id3tag");
    if (!strcmp(tag, "TDA")) id3tag.appendf("Date: %s", value, "id3tag");
    if (!strcmp(tag, "TDY")) id3tag.appendf("Playlist delay: %s", value, "id3tag");
    if (!strcmp(tag, "TEN")) id3tag.appendf("Encoded by: %s", value, "id3tag");
    if (!strcmp(tag, "TFT")) id3tag.appendf("File type: %s", value, "id3tag");
    if (!strcmp(tag, "TIM")) id3tag.appendf("Time: %s", value, "id3tag");
    if (!strcmp(tag, "TKE")) id3tag.appendf("Initial key: %s", value, "id3tag");
    if (!strcmp(tag, "TLA")) id3tag.appendf("Language(s): %s", value, "id3tag");
    if (!strcmp(tag, "TLE")) id3tag.appendf("Length: %s", value, "id3tag");
    if (!strcmp(tag, "TMT")) id3tag.appendf("Media type: %s", value, "id3tag");
    if (!strcmp(tag, "TOA")) id3tag.appendf("Original artist(s)/performer(s): %s", value, "id3tag");
    if (!strcmp(tag, "TOF")) id3tag.appendf("Original filename: %s", value, "id3tag");
    if (!strcmp(tag, "TOL")) id3tag.appendf("Original Lyricist(s)/text writer(s): %s", value, "id3tag");
    if (!strcmp(tag, "TOR")) id3tag.appendf("Original release year: %s", value, "id3tag");
    if (!strcmp(tag, "TOT")) id3tag.appendf("Original album/Movie/Show title: %s", value, "id3tag");
    if (!strcmp(tag, "TP1")) id3tag.appendf("Lead artist(s)/Lead performer(s)/Soloist(s)/Performing group: %s", value, "id3tag");
    if (!strcmp(tag, "TP2")) id3tag.appendf("Band/Orchestra/Accompaniment: %s", value, "id3tag");
    if (!strcmp(tag, "TP3")) id3tag.appendf("Conductor/Performer refinement: %s", value, "id3tag");
    if (!strcmp(tag, "TP4")) id3tag.appendf("Interpreted, remixed, or otherwise modified by: %s", value, "id3tag");
    if (!strcmp(tag, "TPA")) id3tag.appendf("Part of a set: %s", value, "id3tag");
    if (!strcmp(tag, "TPB")) id3tag.appendf("Publisher: %s", value, "id3tag");
    if (!strcmp(tag, "TRC")) id3tag.appendf("ISRC (International Standard Recording Code): %s", value, "id3tag");
    if (!strcmp(tag, "TRD")) id3tag.appendf("Recording dates: %s", value, "id3tag");
    if (!strcmp(tag, "TRK")) id3tag.appendf("Track number/Position in set: %s", value, "id3tag");
    if (!strcmp(tag, "TSI")) id3tag.appendf("Size: %s", value, "id3tag");
    if (!strcmp(tag, "TSS")) id3tag.appendf("Software/hardware and settings used for encoding: %s", value, "id3tag");
    if (!strcmp(tag, "TT1")) id3tag.appendf("Content group description: %s", value, "id3tag");
    if (!strcmp(tag, "TT2")) id3tag.appendf("Title/Songname/Content description: %s", value, "id3tag");
    if (!strcmp(tag, "TT3")) id3tag.appendf("Subtitle/Description refinement: %s", value, "id3tag");
    if (!strcmp(tag, "TXT")) id3tag.appendf("Lyricist/text writer: %s", value, "id3tag");
    if (!strcmp(tag, "TXX")) id3tag.appendf("User defined text information frame: %s", value, "id3tag");
    if (!strcmp(tag, "TYE")) id3tag.appendf("Year: %s", value, "id3tag");
    if (!strcmp(tag, "UFI")) id3tag.appendf("Unique file identifier: %s", value, "id3tag");
    if (!strcmp(tag, "ULT")) id3tag.appendf("Unsychronized lyric/text transcription: %s", value, "id3tag");
    if (!strcmp(tag, "WAF")) id3tag.appendf("Official audio file webpage: %s", value, "id3tag");
    if (!strcmp(tag, "WAR")) id3tag.appendf("Official artist/performer webpage: %s", value, "id3tag");
    if (!strcmp(tag, "WAS")) id3tag.appendf("Official audio source webpage: %s", value, "id3tag");
    if (!strcmp(tag, "WCM")) id3tag.appendf("Commercial information: %s", value, "id3tag");
    if (!strcmp(tag, "WCP")) id3tag.appendf("Copyright/Legal information: %s", value, "id3tag");
    if (!strcmp(tag, "WPB")) id3tag.appendf("Publishers official webpage: %s", value, "id3tag");
    if (!strcmp(tag, "WXX")) id3tag.appendf("User defined URL link frame: %s", value, "id3tag");

    // V2.3 V2.4 tags
    if (!strcmp(tag, "COMM")) id3tag.appendf("Comment: %s", value, "id3tag");
    if (!strcmp(tag, "OWNE")) id3tag.appendf("Ownership: %s", value, "id3tag");
    if (!strcmp(tag, "PRIV")) id3tag.appendf("Private: %s", value, "id3tag");
    if (!strcmp(tag, "SYLT")) id3tag.appendf("SynLyrics: %s", value, "id3tag");
    if (!strcmp(tag, "TALB")) id3tag.appendf("Album: %s", value, "id3tag");
    if (!strcmp(tag, "TBPM")) id3tag.appendf("BeatsPerMinute: %s", value, "id3tag");
    if (!strcmp(tag, "TCAT")) id3tag.appendf("PodcastCategory: %s", value, "id3tag");
    if (!strcmp(tag, "TCMP")) id3tag.appendf("Compilation: %s", value, "id3tag");
    if (!strcmp(tag, "TCOM")) id3tag.appendf("Composer: %s", value, "id3tag");
    if (!strcmp(tag, "TCON")) id3tag.appendf("ContentType: %s", value, "id3tag");
    if (!strcmp(tag, "TCOP")) id3tag.appendf("Copyright: %s", value, "id3tag");
    if (!strcmp(tag, "TDAT")) id3tag.appendf("Date: %s", value, "id3tag");
    if (!strcmp(tag, "TDES")) id3tag.appendf("PodcastDescription: %s", value, "id3tag");
    if (!strcmp(tag, "TDOR")) id3tag.appendf("Original Release Year: %s", value, "id3tag");
    if (!strcmp(tag, "TDRC")) id3tag.appendf("Publication date: %s", value, "id3tag");
    if (!strcmp(tag, "TDRL")) id3tag.appendf("ReleaseTime: %s", value, "id3tag");
    if (!strcmp(tag, "TENC")) id3tag.appendf("Encoded by: %s", value, "id3tag");
    if (!strcmp(tag, "TEXT")) {} // id3tag.appendf("Lyricist: %s", value, "id3tag");
    if (!strcmp(tag, "TGID")) id3tag.appendf("PodcastID: %s", value, "id3tag");
    if (!strcmp(tag, "TIME")) id3tag.appendf("Time: %s", value, "id3tag");
    if (!strcmp(tag, "TIT1")) id3tag.appendf("Grouping: %s", value, "id3tag");
    if (!strcmp(tag, "TIT2")) id3tag.appendf("Title: %s", value, "id3tag");
    if (!strcmp(tag, "TIT3")) id3tag.appendf("Subtitle: %s", value, "id3tag");
    if (!strcmp(tag, "TLAN")) id3tag.appendf("Language: %s", value, "id3tag");
    if (!strcmp(tag, "TLEN")) id3tag.appendf("Length (ms): %s", value, "id3tag");
    if (!strcmp(tag, "TMED")) id3tag.appendf("Media: %s", value, "id3tag");
    if (!strcmp(tag, "TOAL")) id3tag.appendf("OriginalAlbum: %s", value, "id3tag");
    if (!strcmp(tag, "TOPE")) id3tag.appendf("OriginalArtist: %s", value, "id3tag");
    if (!strcmp(tag, "TOLY")) id3tag.appendf("OriginalLyricist: %s", value, "id3tag");
    if (!strcmp(tag, "TORY")) id3tag.appendf("OriginalReleaseYear: %s", value, "id3tag");
    if (!strcmp(tag, "TPE1")) id3tag.appendf("Artist: %s", value, "id3tag");
    if (!strcmp(tag, "TPE2")) id3tag.appendf("Band: %s", value, "id3tag");
    if (!strcmp(tag, "TPE3")) id3tag.appendf("Conductor: %s", value, "id3tag");
    if (!strcmp(tag, "TPE4")) id3tag.appendf("InterpretedBy: %s", value, "id3tag");
    if (!strcmp(tag, "TPOS")) id3tag.appendf("PartOfSet: %s", value, "id3tag");
    if (!strcmp(tag, "TPUB")) id3tag.appendf("Publisher: %s", value, "id3tag");
    if (!strcmp(tag, "TRCK")) id3tag.appendf("Track: %s", value, "id3tag");
    if (!strcmp(tag, "TRSN")) id3tag.appendf("InternetRadioStationName: %s", value, "id3tag");
    if (!strcmp(tag, "TSSE")) id3tag.appendf("SettingsForEncoding: %s", value, "id3tag");
    if (!strcmp(tag, "TRDA")) id3tag.appendf("RecordingDates: %s", value, "id3tag");
    if (!strcmp(tag, "TSO2")) id3tag.appendf("AlbumArtistSortOrder: %s", value, "id3tag");
    if (!strcmp(tag, "TSOA")) id3tag.appendf("AlbumSortOrder: %s", value, "id3tag");
    if (!strcmp(tag, "TSOP")) id3tag.appendf("PerformerSortOrder: %s", value, "id3tag");
    if (!strcmp(tag, "TSOC")) id3tag.appendf("ComposerSortOrder: %s", value, "id3tag");
    if (!strcmp(tag, "TSOT")) id3tag.appendf("TitleSortOrder: %s", value, "id3tag");
    if (!strcmp(tag, "TXXX")) id3tag.appendf("UserDefinedText: %s", value, "id3tag");
    if (!strcmp(tag, "TYER")) id3tag.appendf("Year: %s", value, "id3tag");
    if (!strcmp(tag, "USER")) id3tag.appendf("TermsOfUse: %s", value, "id3tag");
    if (!strcmp(tag, "USLT")) id3tag.appendf("Lyrics: %s", value, "id3tag");
    if (!strcmp(tag, "WCOM")) id3tag.appendf("Commercial URL: %s", value, "id3tag");
    if (!strcmp(tag, "WFED")) id3tag.appendf("Podcast URL: %s", value, "id3tag");
    if (!strcmp(tag, "WOAF")) id3tag.appendf("File URL: %s", value, "id3tag");
    if (!strcmp(tag, "WOAR")) id3tag.appendf("OfficialArtistWebpage: %s", value, "id3tag");
    if (!strcmp(tag, "WOAS")) id3tag.appendf("Source URL: %s", value, "id3tag");
    if (!strcmp(tag, "WORS")) id3tag.appendf("InternetRadioStationURL: %s", value, "id3tag");
    if (!strcmp(tag, "WXXX")) id3tag.appendf("User defined URL link frame: %s", value, "id3tag");
    if (!strcmp(tag, "XDOR")) id3tag.appendf("OriginalReleaseTime: %s", value, "id3tag");

    if (!id3tag.valid()) {
        AUDIO_LOG_DEBUG("unknown tag: %s", tag);
        return;
    }
    latinToUTF8(id3tag);
    if (id3tag.contains("?xml")) {
        showstreamtitle(id3tag.get());
        return;
    }
    latinToUTF8(id3tag);
    if (id3tag.starts_with("Grouping")) {
        showstreamtitle(id3tag.get());
        return;
    }
    if (id3tag.strlen()) { info(*this, evt_id3data, "%s", id3tag.get()); }
}
// —————————————————————————————————————————————————————————————————————————————————————————————————————————————————————————————————————————————————————————————————————————————————————————————————————
void Audio::latinToUTF8(ps_ptr<char>& buff, bool UTF8check) {
    // most stations send  strings in UTF-8 but a few sends in latin. To standardize this, all latin strings are
    // converted to UTF-8. If UTF-8 is already present, nothing is done and true is returned.
    // A conversion to UTF-8 extends the string. Therefore it is necessary to know the buffer size. If the converted
    // string does not fit into the buffer, false is returned

    uint16_t pos = 0;
    uint16_t in = 0;
    uint16_t out = 0;
    bool     isUTF8 = true;

    // We cannot detect if a given string (or byte sequence) is a UTF-8 encoded text as for example each and every series
    // of UTF-8 octets is also a valid (if nonsensical) series of Latin-1 (or some other encoding) octets.
    // However not every series of valid Latin-1 octets are valid UTF-8 series. So you can rule out strings that do not conform
    // to the UTF-8 encoding schema:

    if (UTF8check) {
        while (buff[pos] != '\0') {
            if (buff[pos] <= 0x7F) { // 0xxxxxxx: ASCII
                pos++;
            } else if ((buff[pos] & 0xE0) == 0xC0) {
                if (pos + 1 >= buff.strlen()) isUTF8 = false;
                // 110xxxxx 10xxxxxx: 2-byte
                if ((buff[pos + 1] & 0xC0) != 0x80) isUTF8 = false;
                if (buff[pos] < 0xC2) isUTF8 = false; // Overlong encoding
                pos += 2;
            } else if ((buff[pos] & 0xF0) == 0xE0) {
                // 1110xxxx 10xxxxxx 10xxxxxx: 3-byte
                if ((buff[pos + 1] & 0xC0) != 0x80 || (buff[pos + 2] & 0xC0) != 0x80) isUTF8 = false;
                if (buff[pos] == 0xE0 && buff[pos + 1] < 0xA0) isUTF8 = false;  // Overlong
                if (buff[pos] == 0xED && buff[pos + 1] >= 0xA0) isUTF8 = false; // UTF-16 surrogate
                pos += 3;
            } else if ((buff[pos] & 0xF8) == 0xF0) {
                // 11110xxx 10xxxxxx 10xxxxxx 10xxxxxx: 4-byte
                if ((buff[pos + 1] & 0xC0) != 0x80 || (buff[pos + 2] & 0xC0) != 0x80 || (buff[pos + 3] & 0xC0) != 0x80) isUTF8 = false;
                if (buff[pos] == 0xF0 && buff[pos + 1] < 0x90) isUTF8 = false;                       // Overlong
                if (buff[pos] > 0xF4 || (buff[pos] == 0xF4 && buff[pos + 1] > 0x8F)) isUTF8 = false; // > U+10FFFF
                pos += 4;
            } else {
                isUTF8 = false; // Invalid first byte
            }
            if (!isUTF8) break;
        }
        if (isUTF8) return; // is UTF-8, do nothing
    }
    ps_ptr<char> iso8859_1;
    iso8859_1.assign(buff.get());

    // Worst-case: all chars are latin1 > 0x7F became 2 Bytes → max length is twice +1
    std::size_t requiredSize = strlen(iso8859_1.get()) * 2 + 1;

    if (buff.size() < requiredSize) { buff.realloc(requiredSize); }

    // coding into UTF-8
    while (iso8859_1[in] != '\0') {
        if (iso8859_1[in] < 0x80) {
            buff[out++] = iso8859_1[in++];
        } else {
            buff[out++] = (0xC0 | (iso8859_1[in] >> 6));
            buff[out++] = (0x80 | (iso8859_1[in] & 0x3F));
            in++;
        }
    }
    buff[out] = '\0';
}
// —————————————————————————————————————————————————————————————————————————————————————————————————————————————————————————————————————————————————————————————————————————————————————————————————————
void Audio::htmlToUTF8(char* str) { // convert HTML to UTF-8

    typedef struct { // --- EntityMap Definition ---
        const char* name;
        uint32_t    codepoint;
    } EntityMap;

    const EntityMap entities[] = {
        {"amp", 0x0026},    // &
        {"lt", 0x003C},     // <
        {"gt", 0x003E},     // >
        {"quot", 0x0022},   // "
        {"apos", 0x0027},   // '
        {"nbsp", 0x00A0},   // non-breaking space
        {"euro", 0x20AC},   // €
        {"copy", 0x00A9},   // ©
        {"reg", 0x00AE},    // ®
        {"trade", 0x2122},  // ™
        {"hellip", 0x2026}, // …
        {"ndash", 0x2013},  // –
        {"mdash", 0x2014},  // —
        {"sect", 0x00A7},   // §
        {"para", 0x00B6}    // ¶
    };

    // --- EntityMap Lookup ---
    auto find_entity = [&](const char* p, uint32_t* codepoint, int* entity_len) {
        for (size_t i = 0; i < sizeof(entities) / sizeof(entities[0]); i++) {
            const char* name = entities[i].name;
            size_t      len = strlen(name);
            if (strncmp(p + 1, name, len) == 0 && p[len + 1] == ';') {
                *codepoint = entities[i].codepoint;
                *entity_len = (int)(len + 2); // &name;
                return 1;
            }
        }
        return 0;
    };

    auto codepoint_to_utf8 = [&](uint32_t cp, char* dst) { // Convert a Codepoint (Unicode) to UTF-8, writes in DST, there is number of bytes back
        if (cp <= 0x7F) {
            dst[0] = cp;
            return 1;
        } else if (cp <= 0x7FF) {
            dst[0] = 0xC0 | (cp >> 6);
            dst[1] = 0x80 | (cp & 0x3F);
            return 2;
        } else if (cp <= 0xFFFF) {
            dst[0] = 0xE0 | (cp >> 12);
            dst[1] = 0x80 | ((cp >> 6) & 0x3F);
            dst[2] = 0x80 | (cp & 0x3F);
            return 3;
        } else if (cp <= 0x10FFFF) {
            dst[0] = 0xF0 | (cp >> 18);
            dst[1] = 0x80 | ((cp >> 12) & 0x3F);
            dst[2] = 0x80 | ((cp >> 6) & 0x3F);
            dst[3] = 0x80 | (cp & 0x3F);
            return 4;
        }
        return -1; // invalid Codepoint
    };

    char* p = str;
    while (*p != '\0') {
        if (p[0] == '&') {
            uint32_t cp;
            int      consumed;
            if (find_entity(p, &cp, &consumed)) { // looking for entity, such as &copy;
                char utf8[5] = {0};
                int  len = codepoint_to_utf8(cp, utf8);
                if (len > 0) {
                    size_t tail_len = strlen(p + consumed);
                    memmove(p + len, p + consumed, tail_len + 1);
                    memcpy(p, utf8, len);
                    p += len;
                    continue;
                }
            }
        }
        if (p[0] == '&' && p[1] == '#') {
            char*    endptr;
            uint32_t codepoint = strtol(p + 2, &endptr, 10);

            if (*endptr == ';' && codepoint <= 0x10FFFF) {
                char utf8[5] = {0};
                int  utf8_len = codepoint_to_utf8(codepoint, utf8);
                if (utf8_len > 0) {
                    //    size_t entity_len = endptr - p + 1;
                    size_t tail_len = strlen(endptr + 1);

                    // Show residual ring to the left
                    memmove(p + utf8_len, endptr + 1, tail_len + 1); // +1 because of '\0'

                    // Copy UTF-8 characters
                    memcpy(p, utf8, utf8_len);

                    // weiter bei neuem Zeichen
                    p += utf8_len;
                    continue;
                }
            }
        }
        p++;
    }
}
// —————————————————————————————————————————————————————————————————————————————————————————————————————————————————————————————————————————————————————————————————————————————————————————————————————
size_t Audio::readAudioHeader(uint32_t bytes) {
    size_t bytesReaded = 0;
    if (m_codec == CODEC_WAV) {
        int res = read_WAV_Header(InBuff.getReadPtr(), bytes);
        if (res >= 0)
            bytesReaded = res;
        else { // error, skip header
            m_controlCounter = 100;
        }
    }
    if (m_codec == CODEC_MP3) {
        int res = read_ID3_Header(InBuff.getReadPtr(), bytes);
        if (res > 0 || m_controlCounter < 100)
            bytesReaded = res;
        else { // error, skip header
            m_controlCounter = 100;
        }
    }
    if (m_codec == CODEC_M4A) {
        int res = read_M4A_Header(InBuff.getReadPtr(), bytes);
        if (res >= 0)
            bytesReaded = res;
        else { // error, skip header
            m_controlCounter = 100;
        }
    }
    if (m_codec == CODEC_AAC) {
        // stream only, no header
        m_audioDataSize = m_audioFileSize;
        m_controlCounter = 100;
    }
    if (m_codec == CODEC_FLAC) {
        int res = read_FLAC_Header(InBuff.getReadPtr(), bytes);
        if (res >= 0)
            bytesReaded = res;
        else { // error
            stopSong();
        }
    }
    if (m_codec == CODEC_OPUS) { m_controlCounter = 100; }
    if (m_codec == CODEC_VORBIS) { m_controlCounter = 100; }
    if (m_codec == CODEC_OGG) { m_controlCounter = 100; }
    if (!isRunning()) {
        AUDIO_LOG_ERROR("Processing stopped due to invalid audio header");
        return 0;
    }
    return bytesReaded;
}
// —————————————————————————————————————————————————————————————————————————————————————————————————————————————————————————————————————————————————————————————————————————————————————————————————————
int Audio::read_WAV_Header(uint8_t* data, size_t len) {

    if (m_controlCounter == 0) {
        m_rwh.cs = 0;
        m_rwh.bts = 0;
        m_controlCounter++;
        if ((*data != 'R') || (*(data + 1) != 'I') || (*(data + 2) != 'F') || (*(data + 3) != 'F')) {
            AUDIO_LOG_ERROR("file has no RIFF tag");
            m_rwh.headerSize = 0;
            return -1; // false;
        } else {
            m_rwh.headerSize = 4;
            return 4; // ok
        }
    }

    if (m_controlCounter == 1) {
        m_controlCounter++;
        m_rwh.cs = (uint32_t)(*data + (*(data + 1) << 8) + (*(data + 2) << 16) + (*(data + 3) << 24) - 8);
        m_rwh.headerSize += 4;
        return 4; // ok
    }

    if (m_controlCounter == 2) {
        m_controlCounter++;
        if ((*data != 'W') || (*(data + 1) != 'A') || (*(data + 2) != 'V') || (*(data + 3) != 'E')) {
            AUDIO_LOG_ERROR("format tag is not WAVE");
            return -1; // false;
        } else {
            m_rwh.headerSize += 4;
            return 4;
        }
    }

    if (m_controlCounter == 3) {
        if ((*data == 'f') && (*(data + 1) == 'm') && (*(data + 2) == 't')) {
            m_controlCounter++;
            m_rwh.headerSize += 4;
            return 4;
        } else {
            m_rwh.headerSize += 4;
            return 4;
        }
    }

    if (m_controlCounter == 4) {
        m_controlCounter++;
        m_rwh.cs = (uint32_t)(*data + (*(data + 1) << 8));
        if (m_rwh.cs > 40) return -1; // false, something going wrong
        m_rwh.bts = m_rwh.cs - 16;    // bytes to skip if fmt chunk is >16
        m_rwh.headerSize += 4;
        return 4;
    }

    if (m_controlCounter == 5) {
        m_controlCounter++;
        uint16_t fc = (uint16_t)(*(data + 0) + (*(data + 1) << 8));                                               // Format code
        uint16_t ch = (uint16_t)(*(data + 2) + (*(data + 3) << 8));                                               // Number of interleaved channels
        uint32_t sr = (uint32_t)(*(data + 4) + (*(data + 5) << 8) + (*(data + 6) << 16) + (*(data + 7) << 24));   // Samplerate
        uint32_t dr = (uint32_t)(*(data + 8) + (*(data + 9) << 8) + (*(data + 10) << 16) + (*(data + 11) << 24)); // Datarate
        uint16_t dbs = (uint16_t)(*(data + 12) + (*(data + 13) << 8));                                            // Data block size
        uint16_t bps = (uint16_t)(*(data + 14) + (*(data + 15) << 8));                                            // Bits per sample

        info(*this, evt_info, "FormatCode: %u", fc);
        // info(*this, evt_info, "Channel: %u", nic);
        // info(*this, evt_info, "SampleRate (Hz): %u", sr);
        info(*this, evt_info, "DataRate: %lu", (long unsigned int)dr);
        info(*this, evt_info, "DataBlockSize: %u", dbs);
        info(*this, evt_info, "BitsPerSample: %u", bps);

        if ((bps != 8) && (bps != 16) && (bps != 24) && (bps != 32)) {
            info(*this, evt_info, "BitsPerSample is %u,  must be 8, 16, 24 or 32", bps);
            stopSong();
            return -1;
        }
        if ((ch != 1) && (ch != 2)) {
            info(*this, evt_info, "num channels is %u,  must be 1 or 2", ch);
            stopSong();
            return -1;
        }
        if (fc != 1) {
            AUDIO_LOG_ERROR("format code is not 1 (PCM)");
            stopSong();
            return -1; // false;
        }
        m_decoder->setRawBlockParams(ch, sr, bps, 0, 0);
        m_nominal_bitrate = ch * sr * bps;
        m_rwh.headerSize += 16;
        return 16; // ok
    }

    if (m_controlCounter == 6) {
        m_controlCounter++;
        m_rwh.headerSize += m_rwh.bts;
        return m_rwh.bts; // skip to data
    }

    if (m_controlCounter == 7) {
        if ((*(data + 0) == 'd') && (*(data + 1) == 'a') && (*(data + 2) == 't') && (*(data + 3) == 'a')) {
            m_controlCounter++;
            //    vTaskDelay(30);
            m_rwh.headerSize += 4;
            return 4;
        } else {
            m_rwh.headerSize++;
            return 1;
        }
    }

    if (m_controlCounter == 8) {
        m_controlCounter++;
        size_t cs = *(data + 0) + (*(data + 1) << 8) + (*(data + 2) << 16) + (*(data + 3) << 24); // read chunkSize
        m_rwh.headerSize += 4;
        if (cs) {
            m_audioDataSize = cs - 44;
        } else { // sometimes there is nothing here
            m_audioDataSize = m_audioFileSize - m_rwh.headerSize;
        }

        m_audioFileDuration = m_audioDataSize / (getSampleRate() * getChannels());
        if (getBitsPerSample() == 16) m_audioFileDuration /= 2;
        info(*this, evt_info, "Duration (s): %u", m_audioFileDuration);
        info(*this, evt_bitrate, "%i", m_nominal_bitrate);
        info(*this, evt_info, "Bitrate (b/s): %lu", m_nominal_bitrate);
        return 4;
    }
    m_controlCounter = 100; // header succesfully read
    m_audioDataStart = m_rwh.headerSize;
    info(*this, evt_info, "Audio-Data-Start: %u", m_audioDataStart);
    info(*this, evt_info, "Audio-Length: %u", m_audioDataSize);
    return 0;
}
// —————————————————————————————————————————————————————————————————————————————————————————————————————————————————————————————————————————————————————————————————————————————————————————————————————
int Audio::read_FLAC_Header(uint8_t* data, size_t len) {

    if (m_rflh.retvalue && m_controlCounter != 0) {
        if (m_rflh.retvalue > len) { // if returnvalue > bufferfillsize
            if (len > InBuff.getMaxBlockSize()) len = InBuff.getMaxBlockSize();
            m_rflh.retvalue -= len; // and wait for more bufferdata
            return len;
        } else {
            size_t tmp = m_rflh.retvalue;
            m_rflh.retvalue = 0;
            return tmp;
        }
        return 0;
    }
    // - - - - - - - - - - - - - - - - - - - - - - - - - - - - - - - - - - - - - - - -
    if (m_controlCounter == FLAC_BEGIN) { // init
        m_rflh.reset();
        m_controlCounter = FLAC_MAGIC;
        m_rflh.picVec.clear();
        return 0;
    }
    // - - - - - - - - - - - - - - - - - - - - - - - - - - - - - - - - - - - - - - - -
    if (m_controlCounter == FLAC_MAGIC) {            /* check MAGIC STRING */
        if (specialIndexOf(data, "OggS", 10) == 0) { // is ogg
            m_rflh.headerSize = 0;
            m_rflh.retvalue = 0;
            m_controlCounter = FLAC_OKAY;
            return 0;
        }
        if (specialIndexOf(data, "fLaC", 10) != 0) {
            if (specialIndexOf(data, "ID3", 10) == 0) { // has ID3 before fLaC
                // Synchsafe-Size
                uint32_t size = (data[6] << 21) | (data[7] << 14) | (data[8] << 7) | data[9];
                size += 10;             // header + body
                m_rflh.retvalue = size; // skip ID3 header + body
                return 0;
            }
            AUDIO_LOG_ERROR("Magic String 'fLaC' not found in header");
            stopSong();
            return -1;
        }

        m_controlCounter = FLAC_MBH; // METADATA_BLOCK_HEADER
        m_rflh.headerSize = 4;
        m_rflh.retvalue = 4;
        return 0;
    }
    // - - - - - - - - - - - - - - - - - - - - - - - - - - - - - - - - - - - - - - - -
    if (m_controlCounter == FLAC_MBH) { /* METADATA_BLOCK_HEADER */
        uint8_t blockType = *data;

        if (!m_rflh.f_lastMetaBlock) {
            if ((blockType & 127) == 0) m_controlCounter = FLAC_SINFO;
            if ((blockType & 127) == 1) m_controlCounter = FLAC_PADDING;
            if ((blockType & 127) == 2) m_controlCounter = FLAC_APP;
            if ((blockType & 127) == 3) m_controlCounter = FLAC_SEEK;
            if ((blockType & 127) == 4) m_controlCounter = FLAC_VORBIS;
            if ((blockType & 127) == 5) m_controlCounter = FLAC_CUESHEET;
            if ((blockType & 127) == 6) m_controlCounter = FLAC_PICTURE;
            if ((blockType & 128)) { m_rflh.f_lastMetaBlock = true; }
            m_rflh.headerSize += 1;
            m_rflh.retvalue = 1;
            return 0;
        }

        m_controlCounter = FLAC_OKAY;

        m_audioDataStart = m_rflh.headerSize;
        m_audioDataSize = m_audioFileSize - m_audioDataStart;
        m_decoder->setRawBlockParams(m_rflh.numChannels, m_rflh.sampleRate, m_rflh.bitsPerSample, m_rflh.totalSamplesInStream, (uint32_t)m_audioDataSize);
        if (m_rflh.picLen) {
            size_t pos = m_audioDataStart;
            info(*this, evt_image, m_rflh.picVec);
        }

        info(*this, evt_info, "Audio-Data-Start: %u", m_audioDataStart);
        info(*this, evt_info, "Audio-Length: %u", m_audioDataSize);
        if (m_rflh.duration) {
            m_rflh.nominalBitrate = (m_audioDataSize * 8) / m_rflh.duration;
            m_nominal_bitrate = m_rflh.nominalBitrate;
            m_audioFileDuration = m_rflh.duration;
            info(*this, evt_info, "Duration (s): %u", m_rflh.duration);
            info(*this, evt_bitrate, "%i", m_nominal_bitrate);
            info(*this, evt_info, "Bitrate (b/s): %lu", m_nominal_bitrate);
        }
        m_rflh.retvalue = 0;
        return 0;
    }
    // - - - - - - - - - - - - - - - - - - - - - - - - - - - - - - - - - - - - - - - -
    if (m_controlCounter == FLAC_SINFO) { /* Stream info block */
        size_t l = bigEndian(data, 3);
        vTaskDelay(2);
        m_rflh.maxBlockSize = bigEndian(data + 5, 2);
        info(*this, evt_info, "FLAC maxBlockSize: %u", m_rflh.maxBlockSize);
        vTaskDelay(2);
        m_rflh.maxFrameSize = bigEndian(data + 10, 3);
        if (m_rflh.maxFrameSize) {
            info(*this, evt_info, "FLAC maxFrameSize: %u", m_rflh.maxFrameSize);
        } else {
            info(*this, evt_info, "FLAC maxFrameSize: N/A");
        }
        if (m_rflh.maxFrameSize > InBuff.getMaxBlockSize()) {
            AUDIO_LOG_ERROR("FLAC maxFrameSize too large!");
            stopSong();
            return -1;
        }
        vTaskDelay(2);
        uint32_t nextval = bigEndian(data + 13, 3);
        m_rflh.sampleRate = nextval >> 4;
        info(*this, evt_info, "FLAC sampleRate (Hz): %lu", (long unsigned int)m_rflh.sampleRate);
        vTaskDelay(2);
        m_rflh.numChannels = ((nextval & 0x06) >> 1) + 1;
        info(*this, evt_info, "FLAC numChannels: %u", m_rflh.numChannels);
        vTaskDelay(2);
        uint8_t bps = (nextval & 0x01) << 4;
        bps += (*(data + 16) >> 4) + 1;
        m_rflh.bitsPerSample = bps;
        if ((bps != 8) && (bps != 16) && (bps != 24)) {
            AUDIO_LOG_ERROR("bits per sample must be 8, 16 or 24, is %i", bps);
            stopSong();
            return -1;
        }
        info(*this, evt_info, "FLAC bitsPerSample: %u", m_rflh.bitsPerSample);
        m_rflh.totalSamplesInStream = bigEndian(data + 17, 4);
        if (m_rflh.totalSamplesInStream) {
            info(*this, evt_info, "total samples in stream: %lu", (long unsigned int)m_rflh.totalSamplesInStream);
        } else {
            info(*this, evt_info, "total samples in stream: N/A");
        }
        if (bps != 0 && m_rflh.totalSamplesInStream && m_rflh.sampleRate) { m_rflh.duration = (long unsigned int)m_rflh.totalSamplesInStream / (long unsigned int)m_rflh.sampleRate; }
        m_controlCounter = FLAC_MBH; // METADATA_BLOCK_HEADER
        m_rflh.retvalue = l + 3;
        m_rflh.headerSize += m_rflh.retvalue;
        return 0;
    }
    // - - - - - - - - - - - - - - - - - - - - - - - - - - - - - - - - - - - - - - - -
    if (m_controlCounter == FLAC_PADDING) { /* PADDING */
        size_t l = bigEndian(data, 3);
        m_controlCounter = FLAC_MBH;
        m_rflh.retvalue = l + 3;
        m_rflh.headerSize += m_rflh.retvalue;
        return 0;
    }
    // - - - - - - - - - - - - - - - - - - - - - - - - - - - - - - - - - - - - - - - -
    if (m_controlCounter == FLAC_APP) { /* APPLICATION */
        size_t l = bigEndian(data, 3);
        m_controlCounter = FLAC_MBH;
        m_rflh.retvalue = l + 3;
        m_rflh.headerSize += m_rflh.retvalue;
        return 0;
    }
    // - - - - - - - - - - - - - - - - - - - - - - - - - - - - - - - - - - - - - - - -
    if (m_controlCounter == FLAC_SEEK) { /* SEEKTABLE */
        size_t l = bigEndian(data, 3);
        m_controlCounter = FLAC_MBH;
        m_rflh.retvalue = l + 3;
        m_rflh.headerSize += m_rflh.retvalue;
        return 0;
    }
    // - - - - - - - - - - - - - - - - - - - - - - - - - - - - - - - - - - - - - - - -
    if (m_controlCounter == FLAC_VORBIS) { /* VORBIS COMMENT */ // field names

        auto parse_flac_timestamp = [&](const char* s) {
            if (!s || *s != '[') return -1;
            int mm = 0, ss = 0, hh = 0;
            if (sscanf(s, "[%d:%d.%d]", &mm, &ss, &hh) == 3) { return mm * 60000 + ss * 1000 + hh * 10; }
            return -1;
        };

        ps_ptr<char> vendorString;
        ps_ptr<char> commentString;
        ps_ptr<char> lyricsBuffer;
        size_t       vendorLength = bigEndian(data, 3);
        size_t       idx = 0;
        data += 3;
        idx += 3;
        size_t vendorStringLength = data[0] + (data[1] << 8) + (data[2] << 16) + (data[3] << 24);
        if (vendorStringLength) {
            data += 4;
            idx += 4;
        }
        if (vendorStringLength > 495) vendorStringLength = 495; // guard
        vendorString.assign((const char*)data, vendorStringLength);
        vendorString.insert("VENDOR_STRING: ", 0);
        info(*this, evt_id3data, "%s", vendorString.get());
        data += vendorStringLength;
        idx += vendorStringLength;
        size_t commentListLength = data[0] + (data[1] << 8) + (data[2] << 16) + (data[3] << 24);
        data += 4;
        idx += 4;

        for (int i = 0; i < commentListLength; i++) {
            (void)i;
            size_t commentLength = data[0] + (data[1] << 8) + (data[2] << 16) + (data[3] << 24);
            data += 4;
            idx += 4;
            if (commentLength) { // guard
                commentString.assign((const char*)data, commentLength);
                if (commentString.starts_with("LYRICS="))
                    lyricsBuffer.clone_from(commentString);
                else
                    info(*this, evt_id3data, "%s", commentString.get());
            }
            data += commentLength;
            idx += commentLength;
            if (idx > vendorLength + 3) { AUDIO_LOG_ERROR("VORBIS COMMENT section is too long"); }
        }
        ps_ptr<char> tmp;
        ps_ptr<char> timestamp;
        timestamp.alloc(12);
        if (lyricsBuffer.valid()) {
            lyricsBuffer.remove_prefix("LYRICS=");
            idx = 0;
            while (idx < lyricsBuffer.size()) {
                int pos = lyricsBuffer.index_of('\n', idx);
                if (pos == -1) break;
                int len = pos - idx + 1;
                tmp.copy_from(lyricsBuffer.get() + idx, len);
                idx += len;
                if (tmp.ends_with("\n")) tmp.truncate_at('\n');
                // tmp content e.g.: [00:27.07]Jetzt kommt die Zeit
                //                   [00:28.84]Auf die ihr euch freut
                timestamp.copy_from(tmp.get(), 10);

                int ms = parse_flac_timestamp(timestamp.c_get());

                // timestamp.remove_chars("[]:.");
                // timestamp.append("0"); // to ms 0028840
                tmp.remove_before(10, true);
                if (tmp.strlen() > 0) {
                    m_syltLines.push_back(std::move(tmp));
                    m_syltTimeStamp.push_back(ms);
                }
            }
            info(*this, evt_info, "audiofile contains synchronized lyrics");
            // for(int i = 0; i < m_syltLines.size(); i++){
            //     info(*this, evt_lyrics, "%07i ms,   %s", m_syltTimeStamp[i], m_syltLines[i].c_get());
            // }
        }
        m_controlCounter = FLAC_MBH;
        m_rflh.retvalue = vendorLength + 3;
        m_rflh.headerSize += m_rflh.retvalue;
        return 0;
    }
    // - - - - - - - - - - - - - - - - - - - - - - - - - - - - - - - - - - - - - - - -
    if (m_controlCounter == FLAC_CUESHEET) { /* CUESHEET */
        size_t l = bigEndian(data, 3);
        m_controlCounter = FLAC_MBH;
        m_rflh.retvalue = l + 3;
        m_rflh.headerSize += m_rflh.retvalue;
        return 0;
    }
    // - - - - - - - - - - - - - - - - - - - - - - - - - - - - - - - - - - - - - - - -
    if (m_controlCounter == FLAC_PICTURE) { /* PICTURE */
        m_rflh.picLen = bigEndian(data, 3);
        m_rflh.picPos = m_rflh.headerSize + 3;
        m_rflh.picVec.push_back(m_rflh.picPos);
        m_rflh.picVec.push_back(m_rflh.picLen);
        AUDIO_LOG_DEBUG("FLAC PICTURE, pos %i, size %i", m_rflh.picPos, m_rflh.picLen);
        m_controlCounter = FLAC_MBH;
        m_rflh.retvalue = m_rflh.picLen + 3;
        m_rflh.headerSize += m_rflh.retvalue;
        return 0;
    }
    return 0;
}
// —————————————————————————————————————————————————————————————————————————————————————————————————————————————————————————————————————————————————————————————————————————————————————————————————————

int Audio::read_ID3_Header(uint8_t* data, size_t len) {
    // - - - - - - - - - - - - - - - - - - - - - - - - - - - - - - - - - - - - - - - -
    if (m_controlCounter == MP3_BEGIN) { /* read ID3 tag and ID3 header size */
        m_controlCounter = MP3_ID3HEADER;
        m_ID3Hdr.reset(); // reset all
        m_ID3Hdr.iBuffSize = 4096;
        m_ID3Hdr.iBuff.alloc(m_ID3Hdr.iBuffSize + 10, "m_ID3Hdr.iBuff");
        memset(m_ID3Hdr.tag, 0, sizeof(m_ID3Hdr.tag));
        return 0;
    }
    if (m_controlCounter == MP3_NEXTID3) {
        m_controlCounter = MP3_ID3HEADER;
        // reset specific
        m_ID3Hdr.id3Size = 0;
        //    m_ID3Hdr.totalId3Size = 0; // if we have more header, id3_1_size + id3_2_size + ....
        m_ID3Hdr.remainingHeaderBytes = 0;
        m_ID3Hdr.v22_tag_length = 0;
        m_ID3Hdr.ID3version = 0;
        m_ID3Hdr.ehsz = 0;
        m_ID3Hdr.framesize = 0;
        m_ID3Hdr.compressed = false;
        m_ID3Hdr.SYLT.size = 0;
        m_ID3Hdr.SYLT.pos = 0;
        m_ID3Hdr.iBuffSize = 4096;
        m_ID3Hdr.iBuff.alloc(m_ID3Hdr.iBuffSize + 10, "m_ID3Hdr.iBuff");
        memset(m_ID3Hdr.tag, 0, sizeof(m_ID3Hdr.tag));
        return 0;
    }

    if (m_controlCounter == MP3_ID3HEADER) {
        m_controlCounter = MP3_EXTHEADER;
        int retval = 0;
        if (!m_f_m3u8data) info(*this, evt_info, "File-Size: %lu", m_audioFileSize);

        m_ID3Hdr.remainingHeaderBytes = 0;
        m_ID3Hdr.ehsz = 0;
        if (specialIndexOf(data, "ID3", 4) != 0) { // ID3 not found
            if (!m_f_m3u8data) { info(*this, evt_info, "file has no ID3 tag, skip metadata"); }
            m_audioDataSize = m_audioFileSize;
            // if(!m_f_m3u8data) info(*this, evt_info, "Audio-Length: %u", m_audioDataSize);
            m_controlCounter = MP3_XING; // have xing?
            return 0;                    // error, no ID3 signature found
        }
        m_ID3Hdr.ID3version = *(data + 3);
        switch (m_ID3Hdr.ID3version) {
            case 2:
                m_f_unsync = (*(data + 5) & 0x80);
                m_f_exthdr = false;
                break;
            case 3:
            case 4:
                m_f_unsync = (*(data + 5) & 0x80); // bit7
                m_f_exthdr = (*(data + 5) & 0x40); // bit6 extended header
                break;
        };
        m_ID3Hdr.id3Size = bigEndian(data + 6, 4, 7); //  ID3v2 size  4 * %0xxxxxxx (shift left seven times!!)
        m_ID3Hdr.id3Size += 10;

        retval = 10;

        // Every read from now may be unsync'd
        if (!m_f_m3u8data) info(*this, evt_info, "ID3 framesSize: %i", m_ID3Hdr.id3Size);
        if (!m_f_m3u8data) info(*this, evt_info, "ID3 version: 2.%i", m_ID3Hdr.ID3version);

        if (m_ID3Hdr.ID3version == 2) { m_controlCounter = MP3_ID3V22; }
        m_ID3Hdr.remainingHeaderBytes = m_ID3Hdr.id3Size;
        m_ID3Size = m_ID3Hdr.id3Size;
        m_ID3Hdr.remainingHeaderBytes -= 10;

        if (m_f_exthdr) {
            m_ID3Hdr.ehsz = bigEndian(data + 10, 4, 7); // syncSave
            info(*this, evt_info, "ID3 extended header, size: %i", m_ID3Hdr.ehsz);
            m_ID3Hdr.ehsz -= 4;
            m_ID3Hdr.remainingHeaderBytes -= 4;
            m_ID3Hdr.id3Size += 4;
            retval += 4;
        }
        return retval;
    }
    // - - - - - - - - - - - - - - - - - - - - - - - - - - - - - - - - - - - - - - - -
    if (m_controlCounter == MP3_EXTHEADER) { // skip extended header if exists
        if (m_ID3Hdr.ehsz > len) {
            m_ID3Hdr.ehsz -= len;
            m_ID3Hdr.remainingHeaderBytes -= len;
            return len;
        } // Throw it away
        else {
            m_controlCounter = MP3_ID3FRAME;
            m_ID3Hdr.remainingHeaderBytes -= m_ID3Hdr.ehsz;
            return m_ID3Hdr.ehsz;
        } // Throw it away
    }
    // - - - - - - - - - - - - - - - - - - - - - - - - - - - - - - - - - - - - - - - -
    if (m_controlCounter == MP3_ID3FRAME) { // read a ID3 frame, get the tag
        if (m_ID3Hdr.remainingHeaderBytes == 0) {
            m_controlCounter = MP3_XING;
            return 0;
        }
        m_controlCounter = MP3_FRAMESIZE;
        m_ID3Hdr.frameid[0] = *(data + 0);
        m_ID3Hdr.frameid[1] = *(data + 1);
        m_ID3Hdr.frameid[2] = *(data + 2);
        m_ID3Hdr.frameid[3] = *(data + 3);
        m_ID3Hdr.frameid[4] = 0;
        for (uint8_t i = 0; i < 4; i++) m_ID3Hdr.tag[i] = m_ID3Hdr.frameid[i]; // tag = frameid
        if (m_ID3Hdr.frameid[0] == 0 && m_ID3Hdr.frameid[1] == 0 && m_ID3Hdr.frameid[2] == 0 && m_ID3Hdr.frameid[3] == 0) {
            // We're in padding
            m_controlCounter = MP3_LASTFRAMES; // all ID3 metadata processed
        }
        m_ID3Hdr.remainingHeaderBytes -= 4;
        return 4;
    }
    // - - - - - - - - - - - - - - - - - - - - - - - - - - - - - - - - - - - - - - - -
    if (m_controlCounter == MP3_FRAMESIZE) { // get the frame size
        m_controlCounter = MP3_TAG;

        if (m_ID3Hdr.ID3version == 4) {
            m_ID3Hdr.framesize = bigEndian(data, 4, 7); // << 7
        } else {
            m_ID3Hdr.framesize = bigEndian(data, 4); // << 8
        }

        uint8_t frameFlag_0 = *(data + 4);
        uint8_t frameFlag_1 = *(data + 5);
        (void)frameFlag_0;
        m_ID3Hdr.compressed = frameFlag_1 & 0x80; // Frame is compressed using [#ZLIB zlib] with 4 bytes for 'decompressed
        uint32_t decompsize = 0;
        if (m_ID3Hdr.compressed) {
            // AUDIO_LOG_INFO("iscompressed");
            decompsize = bigEndian(data + 6, 4);
            (void)decompsize;
            // AUDIO_LOG_INFO("decompsize=%u", decompsize);
            m_ID3Hdr.remainingHeaderBytes -= 6 + 4;
            return 6 + 4;
        }
        m_ID3Hdr.remainingHeaderBytes -= 6;
        return 6;
    }
    // - - - - - - - - - - - - - - - - - - - - - - - - - - - - - - - - - - - - - - - -
    if (m_controlCounter == MP3_SKIP) { // If the frame is larger than m_ID3Hdr.framesize, skip the rest
        if (m_ID3Hdr.framesize > len) {
            m_ID3Hdr.framesize -= len;
            m_ID3Hdr.remainingHeaderBytes -= len;
            return len;
        } else {
            m_controlCounter = MP3_ID3FRAME; // check next frame
            m_ID3Hdr.remainingHeaderBytes -= m_ID3Hdr.framesize;
            return m_ID3Hdr.framesize;
        }
    }
    // - - - - - - - - - - - - - - - - - - - - - - - - - - - - - - - - - - - - - - - -
    if (m_controlCounter == MP3_TAG) { // Read the value
        m_controlCounter = MP3_SKIP;   // only read 256 bytes

        uint8_t textEncodingByte = *(data + 0); // ID3v2 Text-Encoding-Byte
        // $00 – ISO-8859-1 (LATIN-1, Identical to ASCII for values smaller than 0x80).
        // $01 – UCS-2 encoded Unicode with BOM (Byte Order Mark), in ID3v2.2 and ID3v2.3.
        // $02 – UTF-16BE encoded Unicode without BOM (Byte Order Mark) , in ID3v2.4.
        // $03 – UTF-8 encoded Unicode, in ID3v2.4.

        if (startsWith(m_ID3Hdr.tag, "APIC")) { // a image embedded in file, passing it to external function
            m_ID3Hdr.APIC_vec.push_back(m_ID3Hdr.totalId3Size + m_ID3Hdr.id3Size - m_ID3Hdr.remainingHeaderBytes);
            m_ID3Hdr.APIC_vec.push_back(m_ID3Hdr.framesize);
            AUDIO_LOG_DEBUG("APIC_pos %i, APIC_size %i", m_ID3Hdr.APIC_vec[2 * m_ID3Hdr.numID3Header], m_ID3Hdr.APIC_vec[2 * m_ID3Hdr.numID3Header + 1]);
            return 0;
        }

        if (startsWith(m_ID3Hdr.tag, "SYLT") || startsWith(m_ID3Hdr.tag, "USLT")) { // any lyrics embedded in file, passing it to external function
            m_controlCounter = MP3_SYLT;
            return 0;
        }

        if ( // proprietary not standard information
            startsWith(m_ID3Hdr.tag, "PRIV")) {
            ; // AUDIO_LOG_ERROR("PRIV");
            return 0;
        }
        if (startsWith(m_ID3Hdr.tag, "TSIZ") || startsWith(m_ID3Hdr.tag, "XTRA")) { // tag with invalid length, skip everything and find the first sync word
            m_ID3Hdr.framesize = 0;
            size_t tmp = m_ID3Hdr.remainingHeaderBytes;
            m_ID3Hdr.remainingHeaderBytes = 0;
            return tmp;
        }

        if (m_ID3Hdr.framesize == 0) return 0;

        ps_ptr<char> tmp;
        ps_ptr<char> content_descriptor;
        size_t       fs = m_ID3Hdr.framesize; // fs = size of the frame data field as read from header
        size_t       bytesToCopy = fs;
        size_t       textDataLength = 0;
        uint16_t     idx = 0;

        if (bytesToCopy >= m_ID3Hdr.iBuffSize) { bytesToCopy = m_ID3Hdr.iBuffSize - 1; } // make sure a zero terminator fits
        if (bytesToCopy > 0) { textDataLength = bytesToCopy - 1; }                       // Only if there are data that we can shorten
        for (int i = 0; i < textDataLength; i++) {
            m_ID3Hdr.iBuff[i] = *(data + i + 1); // Skipped the first byte (Encoding)
        }

        if (textEncodingByte == 1 || textEncodingByte == 2) { // is UTF-16LE or UTF-16BE
            m_ID3Hdr.iBuff[textDataLength] = 0;               // UTF-16: set double zero terminator
            m_ID3Hdr.iBuff[textDataLength + 1] = 0;           // second '\0' for UTF-16
        } else {
            m_ID3Hdr.iBuff[textDataLength] = 0; // only one '\0' for ISO-8859-1 or UTF-8
        }

        m_ID3Hdr.framesize -= fs;

        uint16_t dataLength = fs - 1;
        bool     isBigEndian = (textEncodingByte == 2);

        char encodingTab[4][12] = {"ISO-8859-1", "UTF-16", "UTF-16BE", "UTF-8"};

        if (startsWith(m_ID3Hdr.tag, "COMM")) { // language code
            m_ID3Hdr.lang[0] = m_ID3Hdr.iBuff[0];
            m_ID3Hdr.lang[1] = m_ID3Hdr.iBuff[1];
            m_ID3Hdr.lang[2] = m_ID3Hdr.iBuff[2];
            m_ID3Hdr.lang[3] = '\0';

            idx = 4;
            if (textEncodingByte == 1 || textEncodingByte == 2) idx++;

            uint16_t cd_len = 0;
            if (textEncodingByte == 0)
                cd_len = 1 + content_descriptor.copy_from_iso8859_1((const uint8_t*)(m_ID3Hdr.iBuff.get() + idx)); // iso8859_1
            else if (textEncodingByte == 3)
                cd_len = 1 + content_descriptor.copy_from((const char*)(m_ID3Hdr.iBuff.get() + idx)); // utf-8
            else
                cd_len = 2 + content_descriptor.copy_from_utf16((const uint8_t*)(m_ID3Hdr.iBuff.get() + idx), isBigEndian); // utf-16
            if (cd_len > 2) info(*this, evt_info, "Comment: text encoding; %s, language %s, content_descriptor: %s", encodingTab[textEncodingByte], m_ID3Hdr.lang, content_descriptor.c_get());

            idx += cd_len;
            // AUDIO_LOG_INFO("Tag: %s, Length: %i, Format: %s", m_ID3Hdr.tag, textDataLength, encodingTab[textEncodingByte]);
        } else {
            if (textEncodingByte == 0) {
                tmp.copy_from_iso8859_1((const uint8_t*)m_ID3Hdr.iBuff.get() + idx);
            } // ISO-8859-1
            else if (textEncodingByte == 1 || textEncodingByte == 2) {
                tmp.copy_from_utf16((const uint8_t*)m_ID3Hdr.iBuff.get() + idx, isBigEndian);
            } // UTF-16LE oder UTF-16BE
            else if (textEncodingByte == 3) {
                tmp.copy_from(m_ID3Hdr.iBuff.get() + idx);
            } // UTF-8 copy directly because no conversion is necessary
        }
        showID3Tag(m_ID3Hdr.tag, tmp.c_get());
        m_ID3Hdr.remainingHeaderBytes -= fs;
        return fs;
    }
    // - - - - - - - - - - - - - - - - - - - - - - - - - - - - - - - - - - - - - - - -
    if (m_controlCounter == MP3_SYLT) { // SYLT
        m_controlCounter = MP3_SKIP;
        if (m_dataMode == AUDIO_LOCALFILE || (m_streamType == ST_WEBFILE)) {
            ps_ptr<char> tmp;
            ps_ptr<char> content_descriptor;
            ps_ptr<char> syltBuff;
            bool         isBigEndian = true;
            size_t       len = 0;
            int          idx = 0;
            m_ID3Hdr.SYLT.pos = m_ID3Hdr.id3Size - m_ID3Hdr.remainingHeaderBytes;
            m_ID3Hdr.SYLT.size = m_ID3Hdr.framesize;
            if (m_ID3Hdr.SYLT.size < len) return 0;
            syltBuff.copy_from((const char*)data, m_ID3Hdr.SYLT.size);
            m_ID3Hdr.SYLT.text_encoding = syltBuff[0]; // 0=ISO-8859-1, 1=UTF-16, 2=UTF-16BE, 3=UTF-8
            if (m_ID3Hdr.SYLT.text_encoding == 1) isBigEndian = false;
            if (m_ID3Hdr.SYLT.text_encoding > 3) {
                AUDIO_LOG_ERROR("unknown text encoding: %i", m_ID3Hdr.SYLT.text_encoding);
                m_ID3Hdr.SYLT.text_encoding = 0;
            }
            char encodingTab[4][12] = {"ISO-8859-1", "UTF-16", "UTF-16BE", "UTF-8"};
            memcpy(m_ID3Hdr.SYLT.lang, syltBuff.get() + 1, 3);
            m_ID3Hdr.SYLT.lang[3] = '\0';
            info(*this, evt_info, "Lyrics: text_encoding: %s, language: %s, size %i", encodingTab[m_ID3Hdr.SYLT.text_encoding], m_ID3Hdr.SYLT.lang, m_ID3Hdr.SYLT.size);
            m_ID3Hdr.SYLT.time_stamp_format = syltBuff[4];
            m_ID3Hdr.SYLT.content_type = syltBuff[5];
            idx = 6;
            uint16_t cd_len = 0;
            if (m_ID3Hdr.SYLT.text_encoding == 0)
                cd_len = 1 + content_descriptor.copy_from_iso8859_1((const uint8_t*)(syltBuff.get() + idx)); // iso8859_1
            else if (m_ID3Hdr.SYLT.text_encoding == 3)
                cd_len = 1 + content_descriptor.copy_from((const char*)(syltBuff.get() + idx)); // utf-8
            else
                cd_len = 2 + content_descriptor.copy_from_utf16((const uint8_t*)(syltBuff.get() + idx), isBigEndian); // utf-16
            if (cd_len > 2) info(*this, evt_info, "Lyrics: content_descriptor: %s", content_descriptor.c_get());

            idx += cd_len;
            while (idx < m_ID3Hdr.SYLT.size) {
                if (m_ID3Hdr.SYLT.text_encoding == 0)
                    idx += 1 + tmp.copy_from_iso8859_1((const uint8_t*)syltBuff.get() + idx); // ISO8859_1
                else if (m_ID3Hdr.SYLT.text_encoding == 3)
                    idx += 1 + tmp.copy_from((const char*)syltBuff.get() + idx); // UTF-8
                else
                    idx += 2 + tmp.copy_from_utf16((const uint8_t*)(syltBuff.get() + idx), isBigEndian); // UTF-16LE, UTF-16BE

                if (tmp.starts_with("\n")) tmp.remove_before(1);
                m_syltLines.push_back(std::move(tmp));
                if (idx + 4 > m_ID3Hdr.SYLT.size) break; // no more 4 bytes?
                uint32_t timestamp = bigEndian((uint8_t*)syltBuff.get() + idx, 4);
                m_syltTimeStamp.push_back(timestamp);
                idx += 4;
            }
            info(*this, evt_info, "audiofile contains synchronized lyrics");
            // for(int i = 0; i < m_syltLines.size(); i++){
            //     info(*this, evt_lyrics, "%07i ms,   %s", m_syltTimeStamp[i], m_syltLines[i].c_get());
            // }
        }
        return 0;
    }

    // - - - - - - - - - - - - - - - - - - - - - - - - - - - - - - - - - - - - - - - -

    // --- section V2.2 only , higher Vers above ----
    // see https://mutagen-specs.readthedocs.io/en/latest/id3/id3v2.2.html
    if (m_controlCounter == MP3_ID3V22) { // frames in V2.2, 3bytes identifier, 3bytes size descriptor

        if (m_ID3Hdr.v22_tag_length > 0) {
            if (m_ID3Hdr.v22_tag_length > len) {
                m_ID3Hdr.v22_tag_length -= len;
                return len;
            } // Throw it away
            else {
                uint32_t t = m_ID3Hdr.v22_tag_length;
                m_ID3Hdr.v22_tag_length = 0;
                return t;
            } // Throw it away
        }

        if (m_ID3Hdr.remainingHeaderBytes == 0) {
            m_controlCounter = MP3_LASTFRAMES;
            return 0;
        }

        ps_ptr<char> tag;
        ps_ptr<char> value;
        if (data[0] == 0) { // we are in padding
            m_controlCounter = MP3_LASTFRAMES;
            uint16_t padding = m_ID3Hdr.remainingHeaderBytes;
            m_ID3Hdr.remainingHeaderBytes = 0;
            return padding;
        }
        tag.copy_from((const char*)data, 3);
        m_ID3Hdr.v22_tag_length = bigEndian(data + 3, 3) + 6;
        value.copy_from((const char*)data + 7, min(m_ID3Hdr.v22_tag_length - 7, (size_t)1024));

        if (tag.starts_with("PIC")) { // image embedded in header
            size_t   pic_len = bigEndian(data + 3, 3);
            uint32_t pic_start = m_ID3Hdr.totalId3Size + m_ID3Hdr.id3Size - m_ID3Hdr.remainingHeaderBytes;

            m_ID3Hdr.APIC_vec.push_back(pic_start + 6);
            m_ID3Hdr.APIC_vec.push_back(pic_len);
        } else if (startsWith(m_ID3Hdr.tag, "SLT")) { // lyrics embedded in header
            if (m_dataMode == AUDIO_LOCALFILE) {

                ps_ptr<char> tmp;
                ps_ptr<char> content_descriptor;
                ps_ptr<char> syltBuff;
                bool         isBigEndian = true;
                size_t       len = 0;
                int          idx = 0;

                m_ID3Hdr.SYLT.pos = m_ID3Hdr.id3Size - m_ID3Hdr.remainingHeaderBytes;
                m_ID3Hdr.SYLT.size = m_ID3Hdr.v22_tag_length;
                if (m_ID3Hdr.SYLT.size < len) return 0;
                syltBuff.copy_from((const char*)data, m_ID3Hdr.SYLT.size);
                m_ID3Hdr.SYLT.text_encoding = syltBuff[0];
                memcpy(m_ID3Hdr.SYLT.lang, syltBuff.get() + 1, 3);
                m_ID3Hdr.SYLT.lang[3] = '\0';
                info(*this, evt_info, "Lyrics: text_encoding: %s, language: %s, size %i",
                     m_ID3Hdr.SYLT.text_encoding == 0   ? "ASCII"
                     : m_ID3Hdr.SYLT.text_encoding == 3 ? "UTF-8"
                                                        : "?",
                     m_ID3Hdr.SYLT.lang, m_ID3Hdr.SYLT.size);
                m_ID3Hdr.SYLT.time_stamp_format = syltBuff[4];
                m_ID3Hdr.SYLT.content_type = syltBuff[5];

                idx = 6;

                if (m_ID3Hdr.SYLT.text_encoding == 0 || m_ID3Hdr.SYLT.text_encoding == 3) { // utf-8
                    len = content_descriptor.copy_from((const char*)(syltBuff.get() + idx));
                } else { // utf-16
                    len = content_descriptor.copy_from_utf16((const uint8_t*)(syltBuff.get() + idx), isBigEndian);
                }
                if (len > 2) info(*this, evt_info, "Lyrics: content_descriptor: %s", content_descriptor.c_get());
                idx += len;

                while (idx < m_ID3Hdr.SYLT.size) {
                    // UTF-16LE, UTF-16BE
                    if (m_ID3Hdr.SYLT.text_encoding == 1 || m_ID3Hdr.SYLT.text_encoding == 2) {
                        idx += tmp.copy_from_utf16((const uint8_t*)(syltBuff.get() + idx), isBigEndian);
                    } else {
                        // ISO-8859-1 / UTF-8
                        idx += tmp.copy_from((const char*)syltBuff.get() + idx);
                    }
                    if (tmp.starts_with("\n")) tmp.remove_before(1);
                    m_syltLines.push_back(std::move(tmp));

                    if (idx + 4 > m_ID3Hdr.SYLT.size) break; // no more 4 bytes?

                    uint32_t timestamp = bigEndian((uint8_t*)syltBuff.get() + idx, 4);
                    m_syltTimeStamp.push_back(timestamp);

                    idx += 4;
                }
                info(*this, evt_info, "audiofile contains synchronized lyrics");
                // for(int i = 0; i < m_syltLines.size(); i++){
                //     info(*this, evt_lyrics, "%07i ms,   %s", m_syltTimeStamp[i], m_syltLines[i].c_get());
                // }
            }
        } else {
            showID3Tag(tag.c_get(), value.c_get());
        }

        m_ID3Hdr.remainingHeaderBytes -= m_ID3Hdr.v22_tag_length;

        return 0;
    }
    // -- end section V2.2 -----------

    // - - - - - - - - - - - - - - - - - - - - - - - - - - - - - - - - - - - - - - - -
    if (m_controlCounter == MP3_LASTFRAMES) { // skip all ID3 metadata (mostly spaces)
        if (m_ID3Hdr.remainingHeaderBytes > len) {
            m_ID3Hdr.remainingHeaderBytes -= len;
            return len;
        } // Throw it away
        else {
            m_controlCounter = MP3_XING;
            return m_ID3Hdr.remainingHeaderBytes;
        } // Throw it away
    }
    // - - - - - - - - - - - - - - - - - - - - - - - - - - - - - - - - - - - - - - - -
    if (m_controlCounter == MP3_XING) { //  exist another ID3tag?

        static const int samplerate_table[4][3] = {
            {11025, 12000, 8000},  // MPEG 2.5
            {0, 0, 0},             // reserved
            {22050, 24000, 16000}, // MPEG 2
            {44100, 48000, 32000}  // MPEG 1
        };

        static const int samples_per_frame[4][4] = {// layer:   0    1      2      3
                                                    /* V2.5 */ {0, 576, 1152, 384},
                                                    /* res. */ {0, 0, 0, 0},
                                                    /* V2   */ {0, 576, 1152, 384},
                                                    /* V1   */ {0, 1152, 1152, 384}};

        m_audioDataStart += m_ID3Hdr.id3Size;
        m_ID3Hdr.totalId3Size += m_ID3Hdr.id3Size;
        m_ID3Hdr.id3Size = 0;

        if ((*(data + 0) == 'I') && (*(data + 1) == 'D') && (*(data + 2) == '3')) {
            m_controlCounter = MP3_NEXTID3;
            m_ID3Hdr.numID3Header++;
            return 0;
        } else {
            // padding after ID3 body?
            uint32_t padding_counter = 0;
            while (data[padding_counter] == 0) {
                padding_counter++;
                m_audioDataStart++;
                m_audioDataSize--;
            }
            if (padding_counter) return padding_counter;

            m_controlCounter = MP3_OKAY; // 100 -> ok
            m_audioDataSize = m_audioFileSize - m_audioDataStart;
            if (!m_f_m3u8data) info(*this, evt_info, "Audio-Data-Start: %u", m_audioDataStart);
            if (!m_f_m3u8data) info(*this, evt_info, "Audio-Length: %u", m_audioDataSize);

            uint32_t hdr = bigEndian(data, 4);
            if ((hdr & 0xFFE00000) != 0xFFE00000) AUDIO_LOG_ERROR("Syncword not found"); // check sync
            int versionID = (hdr >> 19) & 0x3;                                           // 0=MPEG2.5, 2=MPEG2, 3=MPEG1
            int layerIndex = (hdr >> 17) & 0x3;                                          // 1=Layer3
            int bitrateIdx = (hdr >> 12) & 0xF;
            int samplerateIdx = (hdr >> 10) & 0x3;
            int mode = (hdr >> 6) & 0x3; // 0=stereo,3=mono
            int samplerate = samplerate_table[versionID][samplerateIdx];
            int spf = samples_per_frame[versionID][layerIndex];

            // Xing or Info Header present?
            int8_t mp3_xing = specialIndexOf(data, "Xing", 50);
            int8_t mp3_info = specialIndexOf(data, "Info", 50);

            uint8_t xingPos = 0;
            if (mp3_xing > 0) xingPos = mp3_xing;
            if (mp3_info > 0) xingPos = mp3_info;

            if (xingPos > 0 && layerIndex == 1) { // layer III only
                uint32_t frames = bigEndian(data + xingPos + 8, 4);
                AUDIO_LOG_DEBUG("frames %i", frames);
                uint32_t bytes = bigEndian(data + xingPos + 12, 4);
                AUDIO_LOG_DEBUG("bytes %i", bytes);
                uint32_t duration = frames * spf / samplerate;
                info(*this, evt_info, "Duration (s): %u", duration);
                m_audioFileDuration = duration;
                uint32_t bitrate = bytes * 8 / duration;
                info(*this, evt_info, "Bitrate (b/s): %u", bitrate);
                m_nominal_bitrate = bitrate;
                info(*this, evt_bitrate, "%i", m_nominal_bitrate);
            }

            if (m_ID3Hdr.APIC_vec.size()) { // if we have a APIC
                info(*this, evt_image, m_ID3Hdr.APIC_vec);
                m_ID3Hdr.APIC_vec.clear();
                AUDIO_LOG_DEBUG("m_ID3Hdr.totalId3Size %i, m_audioDataStart %i", m_ID3Hdr.totalId3Size, m_audioDataStart);
                if (m_ID3Hdr.totalId3Size != m_audioDataStart) audioFileSeek(m_audioDataStart);
            }
            m_ID3Hdr.numID3Header = 0;
            m_ID3Hdr.totalId3Size = 0;
            m_ID3Hdr.iBuff.reset();
            return 0;
        }
    }
    return 0;
}
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
