VaraiTamas/yoRadio/yoRadio/src/Touch/FT6X36/FT6X36.cpp

#include "../../core/options.h"
#if TS_MODEL == TS_MODEL_FT6X36
    #include "FT6X36.h"

FT6X36* FT6X36::_instance = nullptr;

FT6X36::FT6X36(TwoWire* wire, int8_t intPin) {
    _instance = this;
    _wire = wire;
    _intPin = intPin;
}

FT6X36::~FT6X36() {
    detachInterrupt(digitalPinToInterrupt(_intPin));
}

void ISR_ATTR FT6X36::isr() {
    if (_instance) _instance->onInterrupt();
}

bool FT6X36::begin(uint8_t threshold) {
    if (readRegister8(FT6X36_REG_PANEL_ID) != FT6X36_VENDID) return false;

    uint8_t id = readRegister8(FT6X36_REG_CHIPID);
    if (id != FT6206_CHIPID && id != FT6236_CHIPID && id != FT6336_CHIPID) return false;
        pinMode(_intPin, INPUT_PULLUP);
        attachInterrupt(digitalPinToInterrupt(_intPin), FT6X36::isr, FALLING);
    writeRegister8(FT6X36_REG_DEVICE_MODE, 0x00);
    writeRegister8(FT6X36_REG_THRESHHOLD, threshold);
    writeRegister8(FT6X36_REG_TOUCHRATE_ACTIVE, 0x0E);

    return true;
}

void FT6X36::registerIsrHandler(void (*fn)()) {
    _isrHandler = fn;
}

void FT6X36::registerTouchHandler(void (*fn)(TPoint point, TEvent e)) {
    _touchHandler = fn;
}

uint8_t FT6X36::touched() {
    uint8_t n = readRegister8(FT6X36_REG_NUM_TOUCHES);
    if (n > 2) { n = 0; }
    return n;
}

void FT6X36::loop() {
   if (_irqPending)
{
    _irqPending = false;
    processTouch();
}

}

void FT6X36::processTouch() {
    readData();
    uint8_t   n = 0;
    TRawEvent event = (TRawEvent)_touchEvent[n];
    TPoint    point{_touchX[n], _touchY[n]};

    if (event == TRawEvent::PressDown) {
        _points[0] = point;
        _pointIdx = 1;
        _dragMode = false;
        _touchStartTime = millis();
        fireEvent(point, TEvent::TouchStart);
    } else if (event == TRawEvent::Contact) {
        if (_pointIdx < 10) {
            _points[_pointIdx] = point;
            _pointIdx += 1;
        }
        if (!_dragMode && _points[0].aboutEqual(point) && millis() - _touchStartTime > 300) {
            _dragMode = true;
            fireEvent(point, TEvent::DragStart);
        } else if (_dragMode)
            fireEvent(point, TEvent::DragMove);

        fireEvent(point, TEvent::TouchMove);
    } else if (event == TRawEvent::LiftUp) {
        _points[9] = point;
        _touchEndTime = millis();
        fireEvent(point, TEvent::TouchEnd);
        if (_dragMode) {
            fireEvent(point, TEvent::DragEnd);
            _dragMode = false;
        }
        if (_points[0].aboutEqual(point) && _touchEndTime - _touchStartTime <= 300) {
            fireEvent(point, TEvent::Tap);
            _points[0] = {0, 0};
            _touchStartTime = 0;
        }
    } else {
    }
}

void FT6X36::onInterrupt() {
    _irqPending = true;
    if (_isrHandler) { _isrHandler(); }
}

void FT6X36::readData(void) {
    const uint8_t size = 16;
    uint8_t       data[size];
    _wire->beginTransmission(FT6X36_ADDR);
    _wire->write(0);
    _wire->endTransmission();

    _wire->requestFrom((uint8_t)FT6X36_ADDR, size);
    for (uint8_t i = 0; i < size; i++) data[i] = Wire.read();

    #ifdef FT6X36_DEBUG
    Serial.println("REGISTERS:");
    for (int16_t i = 0; i < size; i++) {
        Serial.print("0x");
        Serial.print(i, HEX);
        Serial.print(" = 0x");
        Serial.println(data[i], HEX);
    }

    Serial.println();
    Serial.print("TOUCHES: ");
    Serial.println(data[FT6X36_REG_NUM_TOUCHES]);
    Serial.print("GESTURE: ");
    Serial.println(data[FT6X36_REG_GESTURE_ID]);
    #endif
    _touches = data[FT6X36_REG_NUM_TOUCHES];

    const uint8_t addrShift = 6;
    for (uint8_t i = 0; i < 2; i++) {
        _touchX[i] = data[FT6X36_REG_P1_XH + i * addrShift] & 0x0F;
        _touchX[i] <<= 8;
        _touchX[i] |= data[FT6X36_REG_P1_XL + i * addrShift];
        _touchY[i] = data[FT6X36_REG_P1_YH + i * addrShift] & 0x0F;
        _touchY[i] <<= 8;
        _touchY[i] |= data[FT6X36_REG_P1_YL + i * addrShift];
        _touchEvent[i] = data[FT6X36_REG_P1_XH + i * addrShift] >> 6;
    }
}

void FT6X36::writeRegister8(uint8_t reg, uint8_t value) {
    _wire->beginTransmission(FT6X36_ADDR);
    _wire->write(reg);
    _wire->write(value);
    _wire->endTransmission();
}

uint8_t FT6X36::readRegister8(uint8_t reg) {
    _wire->beginTransmission(FT6X36_ADDR);
    _wire->write(reg);
    _wire->endTransmission();

    _wire->requestFrom((uint8_t)FT6X36_ADDR, (uint8_t)1);
    uint8_t value = _wire->read();

    #ifdef I2C_DEBUG
    Serial.print("REG 0x");
    Serial.print(reg, HEX);
    Serial.print(": 0x");
    Serial.println(value, HEX);
    #endif

    return value;
}

void FT6X36::fireEvent(TPoint point, TEvent e) {
    if (_touchHandler) _touchHandler(point, e);
}

    #ifdef FT6X36_DEBUG
void FT6X36::debugInfo() {
    Serial.print("TH_DIFF: ");
    Serial.println(readRegister8(FT6X36_REG_FILTER_COEF));
    Serial.print("CTRL: ");
    Serial.println(readRegister8(FT6X36_REG_CTRL));
    Serial.print("TIMEENTERMONITOR: ");
    Serial.println(readRegister8(FT6X36_REG_TIME_ENTER_MONITOR));
    Serial.print("PERIODACTIVE: ");
    Serial.println(readRegister8(FT6X36_REG_TOUCHRATE_ACTIVE));
    Serial.print("PERIODMONITOR: ");
    Serial.println(readRegister8(FT6X36_REG_TOUCHRATE_MONITOR));
    Serial.print("RADIAN_VALUE: ");
    Serial.println(readRegister8(FT6X36_REG_RADIAN_VALUE));
    Serial.print("OFFSET_LEFT_RIGHT: ");
    Serial.println(readRegister8(FT6X36_REG_OFFSET_LEFT_RIGHT));
    Serial.print("OFFSET_UP_DOWN: ");
    Serial.println(readRegister8(FT6X36_REG_OFFSET_UP_DOWN));
    Serial.print("DISTANCE_LEFT_RIGHT: ");
    Serial.println(readRegister8(FT6X36_REG_DISTANCE_LEFT_RIGHT));
    Serial.print("DISTANCE_UP_DOWN: ");
    Serial.println(readRegister8(FT6X36_REG_DISTANCE_UP_DOWN));
    Serial.print("DISTANCE_ZOOM: ");
    Serial.println(readRegister8(FT6X36_REG_DISTANCE_ZOOM));
    Serial.print("CIPHER: ");
    Serial.println(readRegister8(FT6X36_REG_CHIPID));
    Serial.print("G_MODE: ");
    Serial.println(readRegister8(FT6X36_REG_INTERRUPT_MODE));
    Serial.print("PWR_MODE: ");
    Serial.println(readRegister8(FT6X36_REG_POWER_MODE));
    Serial.print("FIRMID: ");
    Serial.println(readRegister8(FT6X36_REG_FIRMWARE_VERSION));
    Serial.print("FOCALTECH_ID: ");
    Serial.println(readRegister8(FT6X36_REG_PANEL_ID));
    Serial.print("STATE: ");
    Serial.println(readRegister8(FT6X36_REG_STATE));
}
    #endif
#endif
