VaraiTamas/yoRadio/(notices)

Notices in the files:
yoRadio/src/audioI2S/Audio.cpp:
0x00, 0x00, 0x00, 0x1C, 0xA9, 0x64, 0x61, 0x79, 0x00, 0x00, 0x00, 0x14, 0x64, 0x61, 0x74, 0x61, 0x00, 0x00, 0x00, 0x01, 0x00, 0x00, 0x00, 0x00, 0x32, 0x30, 0x32, 0x32,
sub atom length | © d a y | sub sub atom length | d a t a | data type 1->UTF-8 | reserved | 2 0 2 2
